robmacl/ilemt_hw/README.md

# ilemt_hw
Hardware design files for ILEMT position tracker. The In-Loop
ElectroMagnetic Tracker (ILEMT) is a project for an open design
electromagnetic tracker. See https://github.com/robmacl/ilemt_hw/wiki
