robmacl/ilemt_hw/docs/Rj45_probe_pinout.xlsx

Sheet: By pin
Pin | 1000BASE-T | ILEMT probe | T568A color | T568B color
1 | DA+ | CFG_GND | white/green stripe | white/orange stripe
2 | DA− | CFG_SIGNAL | green solid | orange solid
3 | DB+ | X- | white/orange stripe | white/green stripe
4 | DC+ | Z+ | blue solid | blue solid
5 | DC− | Z- | white/blue stripe | white/blue stripe
6 | DB− | X+ | orange solid | green solid
7 | DD+ | Y- | white/brown stripe | white/brown stripe
8 | DD− | Y+ | brown solid | brown solid
T568A and T568B define signal pairings for 4 pair twisted pair cable, the RJ45 pinout, and also the wire colors for each signal. T658A and T568B differ in that the orange and green pairs are swapped. So from the view of which RJ45 pins are paired, A and B are identical, and these can be regarded as alternate color mappings.
We use the pairing of an ethernet cable, T468 A or B, but the pair ordering differs from all of T568A, T568B, and 1000BASE-T, which also mutually disagree with each other.
So far as signal signs, 1000BASE-T oddly decided to flip the color signs on pins 4,5 (blue). We consistently go with the convention that solid is +.
 | By pin

Sheet: By ethenet signal
Pin | 1000BASE-T | ILEMT probe | T568A color | T568B color
2 | DA− | CFG_SIGNAL | green solid | orange solid
1 | DA+ | CFG_GND | white/green stripe | white/orange stripe
6 | DB− | X+ | orange solid | green solid
3 | DB+ | X- | white/orange stripe | white/green stripe
5 | DC− | Z- | white/blue stripe | white/blue stripe
4 | DC+ | Z+ | blue solid | blue solid
8 | DD− | Y+ | brown solid | brown solid
7 | DD+ | Y- | white/brown stripe | white/brown stripe
 | By ethernet signal

Sheet: By ILEMT signal
Pin | 1000BASE-T | ILEMT probe | T568A color | T568B color
1 | DA+ | CFG_GND | white/green stripe | white/orange stripe
2 | DA− | CFG_SIGNAL | green solid | orange solid
3 | DB+ | X- | white/orange stripe | white/green stripe
6 | DB− | X+ | orange solid | green solid
7 | DD+ | Y- | white/brown stripe | white/brown stripe
8 | DD− | Y+ | brown solid | brown solid
5 | DC− | Z- | white/blue stripe | white/blue stripe
4 | DC+ | Z+ | blue solid | blue solid
 | By ILEMT signal
