robmacl/ilemt_hw/simetrix/antialias_30khz_bw_response.pdf

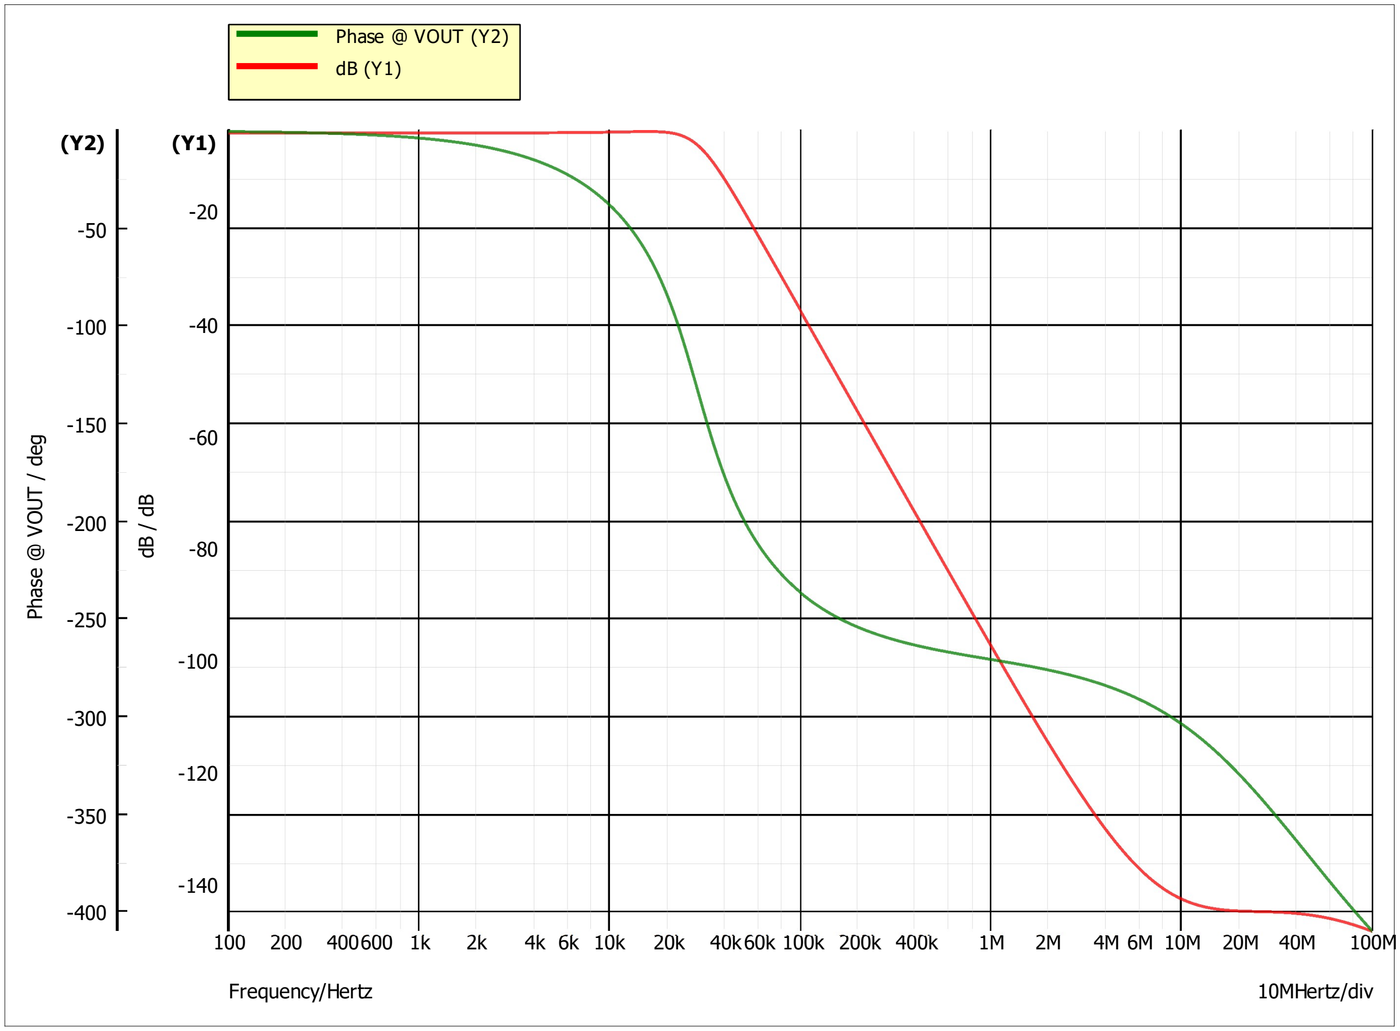
[picture p1: figure]
-20 Phase @ VOUT / deg; Frequency/Hertz; 10MHertz/div; Phase @ VOUT (Y2) dB (Y1)

100 200 400600 1k | 2k | 4k 6k 10k 20k 40k60k 100k 200k 400k | 1M | 2M | 4M 6M 10M 20M 40M | 100M
