robmacl/ilemt_hw/coils/emoto/components/3DV09.pdf

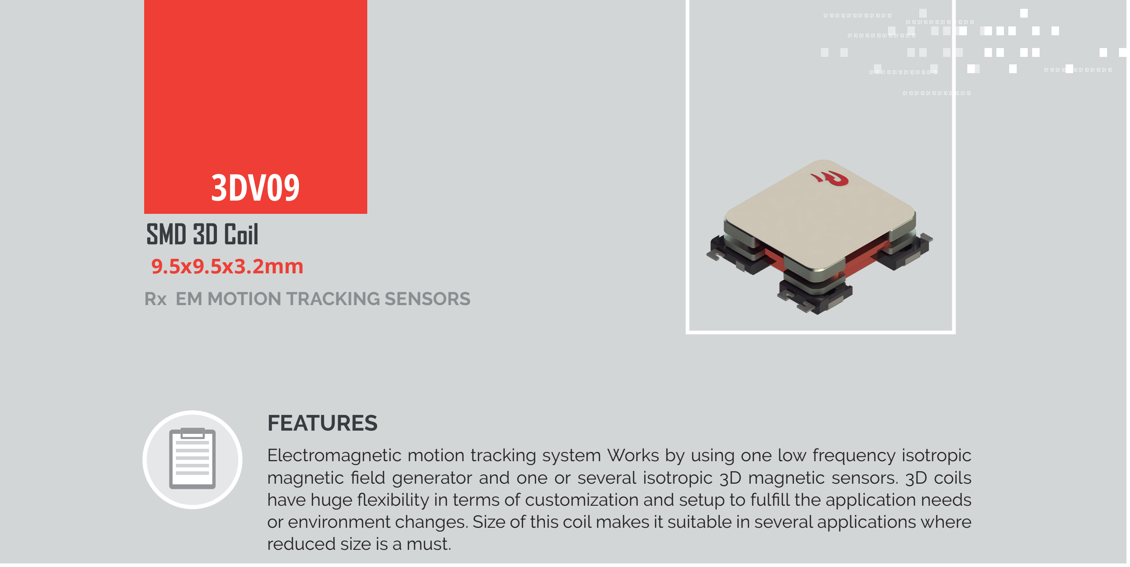
[picture p2: figure]
reduced size is a must.; SMD 3D Coil; FEATURES; Rx EM MOTION TRACKING SENSORS
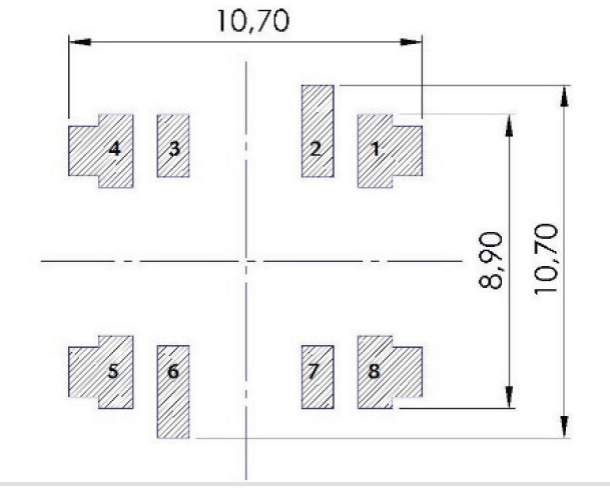
[picture p3: figure]

Electromagnetic motion tracking system Works by using one low frequency isotropic magnetic field generator and one or several isotropic 3D magnetic sensors. 3D coils have huge flexibility in terms of customization and setup to fulfill the application needs or environment changes. Size of this coil makes it suitable in several applications where

> Size 9.5x9.5x3.2 mm
> SMD solution
> Suitable for AOI
> Inductance range: 2-20 mH
> Labelled to allow P&P operations > Sensitivity over 20 mV/A/m.

### 01 CHARACTERISTICS

3DV09

(*) Ask for sensitivity test set up and recommendations

### 02 DIMENSIONS

DIMENSIONS (mm)

ELECTRICAL DIAGRAM

RECOMMENDED PAD-LAYOUT

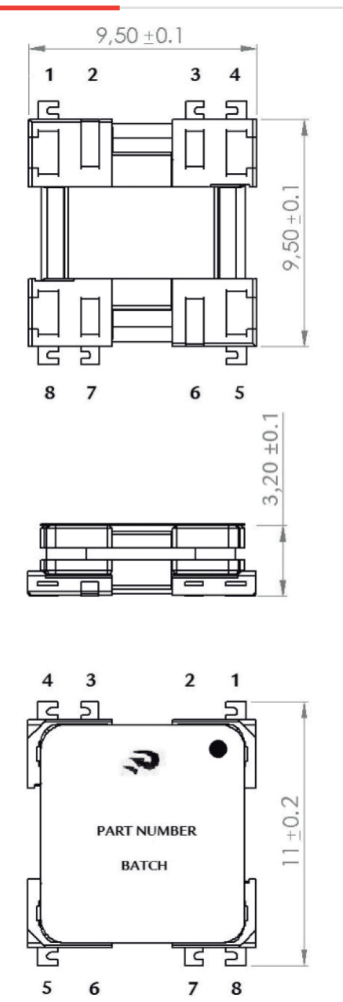
[picture p4: figure]

> Pins coplanarity 0.1 mm

L x,y,z (mH) | 18(xy)/30(z)
Qx,y nom | 4.5(x) /4(y)
4.5(x) /4(y) | 5.5
f(kHz) | 20
SRFx,y (kHz) Min | 150
SRFz (kHz) Min | 450
DCRx (Ohm) Max | 520
DCRy (Ohm) Max | 570
DCRz (Ohm) Max | 715
Sensitivity x,y (mV/A/m) Min (*) | 20
Sensitivity z (mV/A/m) Min (*) | 15
ELECTRICAL SPECIFICATIONS | 3DCV9-A-2000J

Rx EM MOTION TRACKING SENSORS
