robmacl/ilemt_hw/parts/bom_compare.xlsx

Sheet: help
This workbook uses XLOOKUP to reconcile the digikey BOM, Kicad BOM and Digikey cart, comparing quantity in each. On the kicad_bom sheet we also compare the MPN on the Kicad vs. Digikey BOMs. This also detects parts which are in one BOM and not the other. Some quantities for connectors and testpoints are confused because they have different values in the schematic, so are not grouped as a single line. DNP components also create mismatch, since they won't usually be on the Digikey BOM.
Download digikey bom and cart as CSV, open, and copy paste into digikey_bom and cart sheets. Export kicad bom as CSV also, and paste on the kicad_bom sheet. Kicad Tools/Generate bill of materials/bom2grouped_csv. Copy the occupied rectangle from the input CSV, taking care to delete lines if the BOM got shorter.
Since the data is copied in, you are only looking at a particular Kicad project (board) vs. the Digikey info. This is currently for input_board_R1.

Sheet: cart
Index | Quantity | Part Number | Manufacturer Part Number | Description | Customer Reference | Available | Backorder | Unit Price | Extended Price USD | BOM quantity | Cart extra
1 | 4 | HR1645-ND | HR10A-10R-10SB(72) | CONN RCPT FMALE 10POS GOLD SLDR |  | 4 | 0 | 11.62 | 46.48
2 | 4 | HR1634-ND | HR10A-10P-10P(74) | CONN PLUG MALE 10POS SOLDER CUP |  | 4 | 0 | 19.06 | 76.24
3 | 20 | 311-3585-1-ND | CC0805FRNPO0BN102 | CAP CER 1000PF 100V NPO 0805 | I.1 | 20 | 0 | 0.213 | 4.26
4 | 6 | LTC2512CDKD-24#PBF-ND | LTC2512CDKD-24#PBF | IC ADC 24BIT SAR 24DFN | I.3 | 6 | 0 | 21.04 | 126.24
5 | 10 | 240-2396-1-ND | HZ0805C202R-10 | FERRITE BEAD 2 KOHM 0805 1LN | I.5 | 10 | 0 | 0.151 | 1.51
6 | 10 | 311-.068LWCT-ND | RL1206FR-070R068L | RES 0.068 OHM 1% 1/4W 1206 | I.10 | 10 | 0 | 0.361 | 3.61
7 | 10 | 296-8518-1-ND | SN74LVC541ADBR | IC BUF NON-INVERT 3.6V 20SSOP | I.11 | 10 | 0 | 0.477 | 4.77
8 | 10 | AD8599ARZ-ND | AD8599ARZ | IC OPAMP GP 2 CIRCUIT 8SOIC | I.12 | 10 | 0 | 7.84 | 78.40
9 | 10 | CAY16-330J4LFCT-ND | CAY16-330J4LF | RES ARRAY 4 RES 33 OHM 1206 | I.13 | 10 | 0 | 0.065 | 0.65
10 | 10 | 2019-RK73H2BTTD2R74FCT-ND | RK73H2BTTD2R74F | RES 2.74 OHM 1% 1/4W 1206 | I.16 | 10 | 0 | 0.048 | 0.48
11 | 3 | RJHSE5387-ND | RJHSE5387 | CONN MOD JACK 8P8C R/A SHIELDED | I.18 | 3 | 0 | 1.66 | 4.98
12 | 50 | 565-4287-1-ND | APXG160ARA331MHA0G | CAP ALUM POLY 330UF 20% 16V SMD | I.19 | 50 | 0 | 0.7246 | 36.23
13 | 10 | 296-17400-5-ND | OPA830ID | IC OPAMP VFB 1 CIRCUIT 8SOIC | I.20 | 10 | 0 | 2.722 | 27.22
14 | 5 | MF-NSMF050-2CT-ND | MF-NSMF050-2 | PTC RESET FUSE 13.2V 500MA 1206 | I.21 | 5 | 0 | 0.324 | 1.62
15 | 10 | 497-5236-1-ND | 2STD1665T4 | TRANS NPN 65V 6A DPAK | I.22 | 10 | 0 | 0.753 | 7.53
16 | 10 | NSS1C300ET4GOSCT-ND | NSS1C300ET4G | TRANS PNP 100V 3A 3DPAK | I.23 | 10 | 0 | 0.599 | 5.99
17 | 10 | NCP1117STAT3GOSCT-ND | NCP1117STAT3G | IC REG LINEAR POS ADJ 1A SOT223 | I.26 | 10 | 0 | 0.411 | 4.11
18 | 200 | 1276-6471-1-ND | CL21B105KOFNNNG | CAP CER 1UF 16V X7R 0805 | I.27 | 200 | 0 | 0.0243 | 4.86
19 | 10 | 399-5516-1-ND | C1210C476M9RACTU | CAP CER 47UF 6.3V X7R 1210 | I.28 | 10 | 0 | 0.881 | 8.81
20 | 20 | 478-5318-1-ND | 06036D106MAT2A | CAP CER 10UF 6.3V X5R 0603 | I.29 | 20 | 0 | 0.165 | 3.30
21 | 100 | A110514CT-ND | 8-2176091-9 | RES SMD 499 OHM 0.1% 1/4W 0805 | I.30 | 100 | 0 | 0.2568 | 25.68
22 | 3 | 296-46621-1-ND | OPA1679IDR | IC AUDIO 4 CIRCUIT 14SOIC | I.31 | 3 | 0 | 1.23 | 3.69
23 | 10 | S6009-02-ND | NRPN022MAMS-RC | CONN HEADER SMD 4POS 2MM | I.32 | 10 | 0 | 0.392 | 3.92
24 | 4 | 36-1540-2-ND | 1540-2 | TERM TURRET HOLLOW L=6.75MM TIN | I.33 | 4 | 0 | 0.5 | 2.00
25 | 4 | WM5557-ND | 0734151471 | CONN MMCX JACK STR 50 OHM PCB | I.35 | 4 | 0 | 2.53 | 10.12
26 | 15 | 490-6381-1-ND | GRM1885C1H222GA01D | CAP CER 2200PF 50V C0G/NP0 0603 | I.36 | 15 | 0 | 0.133 | 2.00
27 | 10 | FIN1047MTCXFSCT-ND | FIN1047MTCX | IC DRIVER 4/0 16TSSOP | I.38 | 10 | 0 | 1.545 | 15.45
28 | 10 | DS90LV048ATMTC/NOPB-ND | DS90LV048ATMTC/NOPB | IC RECEIVER 0/4 16TSSOP | I.39 | 10 | 0 | 2.904 | 29.04
29 | 20 | 732-9974-1-ND | 824500500 | TVS DIODE 5V 9.2V DO214AC | I.40 | 20 | 0 | 0.252 | 5.04
30 | 10 | P4SMA12A-E3/61GICT-ND | P4SMA12A-E3/61 | TVS DIODE 10.2V 16.7V DO214AC | I.41 | 10 | 0 | 0.274 | 2.74
31 | 10 | 296-46339-1-ND | THS4131CDR | IC OPAMP DIFF 1 CIRCUIT 8SOIC | I.42 | 10 | 0 | 7.343 | 73.43
32 | 100 | BAS21SLT1GOSCT-ND | BAS21SLT1G | DIODE ARRAY GP 250V 225MA SOT23 | I.43 | 81 | 19 | 0.0787 | 7.87
33 | 10 | 311-4211-1-ND | CC0805JKNPO9BN332 | CAP CER 3300PF 50V NPO 0805 | I.45 | 10 | 0 | 0.277 | 2.77
34 | 20 | 445-6945-1-ND | CGA4C2C0G1H682J060AA | CAP CER 6800PF 50V C0G 0805 | I.46 | 20 | 0 | 0.165 | 3.30
35 | 20 | 311-2653-1-ND | RT0603DRE07698RL | RES SMD 698 OHM 0.5% 1/10W 0603 | I.47 | 20 | 0 | 0.092 | 1.84
36 | 10 | RNCP0603FTD392RCT-ND | RNCP0603FTD392R | RES 392 OHM 1% 1/8W 0603 | I.49 | 10 | 0 | 0.058 | 0.58
37 | 20 | RNCP0603FTD301RCT-ND | RNCP0603FTD301R | RES 301 OHM 1% 1/8W 0603 | I.50 | 20 | 0 | 0.058 | 1.16
38 | 20 | P100DBCT-ND | ERA-3AEB101V | RES SMD 100 OHM 0.1% 1/10W 0603 | I.51 | 20 | 0 | 0.26 | 5.20
39 | 100 | RMCF0603FT33R0CT-ND | RMCF0603FT33R0 | RES 33 OHM 1% 1/10W 0603 | I.52 | 100 | 0 | 0.0065 | 0.65
40 | 100 | YAG3354CT-ND | RT0603FRE073K3L | RES SMD 3.3K OHM 1% 1/10W 0603 | I.53 | 100 | 0 | 0.0227 | 2.27
41 | 100 | YAG5945CT-ND | RT0603FRE07200KL | RES SMD 200K OHM 1% 1/10W 0603 | I.54 | 100 | 0 | 0.0227 | 2.27
42 | 100 | RNCP0603FTD200RCT-ND | RNCP0603FTD200R | RES 200 OHM 1% 1/8W 0603 | I.55 | 100 | 0 | 0.0236 | 2.36
43 | 100 | P10KDBCT-ND | ERA-3AEB103V | RES SMD 10K OHM 0.1% 1/10W 0603 | I.56 | 100 | 0 | 0.1015 | 10.15
44 | 10 | P243DBCT-ND | ERA-3AEB2430V | RES SMD 243 OHM 0.1% 1/10W 0603 | I.57 | 10 | 0 | 0.26 | 2.60
45 | 3 | 24LC256T-I/MSCT-ND | 24LC256T-I/MS | IC EEPROM 256KBIT I2C 8MSOP | I.59 | 3 | 0 | 0.84 | 2.52
46 | 3 | 1727-6075-1-ND | 74LVC1G384GV,125 | IC SWITCH SPST 5TSOP | I.60 | 3 | 0 | 0.41 | 1.23
47 | 10 | 399-9672-ND | R60DF4330506AJ | CAP FILM 3.3UF 5% 63VDC RADIAL | M.6 | 10 | 0 | 0.722 | 7.22
48 | 20 | 732-6123-1-ND | 74279220181 | FERRITE BEAD 180 OHM 0805 1LN | M.36 | 20 | 0 | 0.32 | 6.40
49 | 3 | 296-OPA2210IDRCT-ND | OPA2210IDR | IC OPAMP GP 2 CIRCUIT 8SOIC | D.1 | 3 | 0 | 4.57 | 13.71
50 | 50 | 311-1341-1-ND | CC0603KRX7R8BB104 | CAP CER 0.1UF 25V X7R 0603 | I.2 | 50 | 0 | 0.0248 | 1.24
51 | 100 | 541-10TACT-ND | CRCW080510R0JNEAHP | RES SMD 10 OHM 5% 1/2W 0805 | I.9 | 100 | 0 | 0.0757 | 7.57
52 | 25 | 587-1765-1-ND | FBMJ2125HM210NT | FERRITE BEAD 21 OHM 0805 1LN | I.24 | 25 | 0 | 0.07 | 1.75
53 | 10 | 311-1065-1-ND | CC0603JRNPO9BN470 | CAP CER 47PF 50V C0G/NPO 0603 | I.44 | 10 | 0 | 0.038 | 0.38
54 | 100 | YAG1237CT-ND | RT0603BRD071KL | RES SMD 1K OHM 0.1% 1/10W 0603 | I.48 | 100 | 0 | 0.1073 | 10.73
55 | 10 | 311-0.0GRCT-ND | RC0603JR-070RL | RES SMD 0 OHM JUMPER 1/10W 0603 | M.12 | 10 | 0 | 0.017 | 0.17
56 | 100 | WM1138CT-ND | 0039000059 | CONN SOCKET 18-24AWG CRIMP TIN |  | 100 | 0 | 0.061 | 6.10
57 | 20 | WM3700-ND | 0039012020 | CONN RECEPT 2POS DUAL |  | 20 | 0 | 0.194 | 3.88
58 | 10 | WM3701-ND | 0039012040 | CONN RECEPT 4POS DUAL | P.8.1 | 10 | 0 | 0.221 | 2.21
59 | 1 | 2260-SSNC-T5-15G-ND | SSNC-T5-15G | 63/37 SOLDER PASTE T5 - 15 GRAMS |  | 1 | 0 | 16.99 | 16.99
60 | 1 | 2328-18UL1007STRWHI-ND | 18UL1007STRWHI | HOOK-UP STRND 18AWG 300V WHITE |  | 1 | 0 | 20.57 | 20.57
61 | 1 | 2328-18UL1007STRRED-ND | 18UL1007STRRED | HOOK-UP STRND 18AWG 300V RED |  | 1 | 0 | 20.57 | 20.57
62 | 50 | 490-GCM2195C1K103FA16DCT-ND | GCM2195C1K103FA16D | CERAMIC CAP AEC-Q200 | I.14 | 50 | 0 | 0.321 | 16.05
63 | 20 | YAG1859CT-ND | RT0805BRD072KL | RES SMD 2K OHM 0.1% 1/8W 0805 | I.17 | 20 | 0 | 0.259 | 5.18

Sheet: digikey_bom
Manufacturer Part Number | Manufacturer | Digi-Key Part Number | Customer Reference | Reference Designator | Packaging | Quantity | Unit Price | Extended Price | Quantity Available | Description | Cart | Cart extra | Kicad | Kicad diff
OPA2210IDR | Texas Instruments | 296-OPA2210IDRCT-ND | D.1 | U3 | Cut Tape (CT) | 1 | 4.57 | $4.57 | 1201 | IC OPAMP GP 2 CIRCUIT 8SOIC | 3 | 1 | 1 | 0 | Num assemblies:
CC0805FRNPO0BN102 | Yageo | 311-3585-1-ND | I.1 | C31 | Cut Tape (CT) | 6 | 0.31 | $1.86 | 255 | CAP CER 1000PF 100V NPO 0805 | 20 | 8 | 6 | 0 | 2
RL1206FR-070R068L | Yageo | 311-.068LWCT-ND | I.10 | R7 | Cut Tape (CT) | 1 | 0.5 | $0.50 | 30227 | RES 0.068 OHM 1% 1/4W 1206 | 10 | 8 | 1 | 0
SN74LVC541ADBR | Texas Instruments | 296-8518-1-ND | I.11 | U5 | Cut Tape (CT) | 1 | 0.56 | $0.56 | 1491 | IC BUF NON-INVERT 3.6V 20SSOP | 10 | 8 | 1 | 0
AD8599ARZ | Analog Devices Inc. | AD8599ARZ-ND | I.12 | U101 | Tube | 3 | 8.68 | $26.04 | 313 | IC OPAMP GP 2 CIRCUIT 8SOIC | 10 | 4 | 3 | 0
CAY16-330J4LF | Bourns Inc. | CAY16-330J4LFCT-ND | I.13 | RN1 | Cut Tape (CT) | 2 | 0.1 | $0.20 | 215903 | RES ARRAY 4 RES 33 OHM 1206 | 10 | 6 | 2 | 0
GRM2195C1H103GA01D | Murata Electronics | 490-8296-1-ND | I.14 | C1, C2, C32 | Cut Tape (CT) | 16 | 0 | $0.00 | 24000 | CAP CER 10000PF 50V C0G/NP0 0805 | 50 | 18 | 16 | 0
RK73H2BTTD2R74F | KOA Speer Electronics, Inc. | 2019-RK73H2BTTD2R74FCT-ND | I.16 | R6 | Cut Tape (CT) | 1 | 0.1 | $0.10 | 1879 | RES 2.74 OHM 1% 1/4W 1206 | 10 | 8 | 1 | 0
ERA-6AEB202V | Panasonic Electronic Components | P2.0KDACT-ND | I.17 | R1 | Cut Tape (CT) | 5 | 0.31 | $1.55 | 3418 | RES 2K OHM 0.1% 1/8W 0805 | 20 | 10 | 5 | 0
RJHSE5387 | Amphenol ICC (Commercial Products) | RJHSE5387-ND | I.18 | J1 | Tray | 1 | 1.66 | $1.66 | 1520 | CONN MOD JACK 8P8C R/A SHIELDED | 3 | 1 | 1 | 0
APXG160ARA331MHA0G | United Chemi-Con | 565-4287-1-ND | I.19 | C7 | Cut Tape (CT) | 18 | 0.872 | $15.69 | 1024 | CAP ALUM POLY 330UF 20% 16V SMD | 50 | 14 | 18 | 0
CC0603KRX7R8BB104 | Yageo | 311-1341-1-ND | I.2 | C18 | Cut Tape (CT) | 17 | 0.045 | $0.76 | 9242198 | CAP CER 0.1UF 25V X7R 0603 | 50 | 16 | 17 | 0
OPA830ID | Texas Instruments | 296-17400-5-ND | I.20 | U4, U6 | Tube | 2 | 3.03 | $6.06 | 184 | IC OPAMP VFB 1 CIRCUIT 8SOIC | 10 | 6 | 2 | 0
MF-NSMF050-2 | Bourns Inc. | MF-NSMF050-2CT-ND | I.21 | F1, F2 | Cut Tape (CT) | 2 | 0.33 | $0.66 | 5878 | PTC RESET FUSE 13.2V 500MA 1206 | 5 | 1 | 2 | 0
2STD1665T4 | STMicroelectronics | 497-5236-1-ND | I.22 | Q2 | Cut Tape (CT) | 1 | 0.92 | $0.92 | 8311 | TRANS NPN 65V 6A DPAK | 10 | 8 | 1 | 0
NSS1C300ET4G | ON Semiconductor | NSS1C300ET4GOSCT-ND | I.23 | Q1 | Cut Tape (CT) | 2 | 0.69 | $1.38 | 1910 | TRANS PNP 100V 3A 3DPAK | 10 | 6 | 2 | 0
FBMJ2125HM210NT | Taiyo Yuden | 587-1765-1-ND | I.24 | FB1 | Cut Tape (CT) | 9 | 0.11 | $0.99 | 26842 | FERRITE BEAD 21 OHM 0805 1LN | 25 | 7 | 9 | 0
NCP1117STAT3G | ON Semiconductor | NCP1117STAT3GOSCT-ND | I.26 | U8 | Cut Tape (CT) | 2 | 0.48 | $0.96 | 30695 | IC REG LINEAR POS ADJ 1A SOT223 | 10 | 6 | 2 | 0
CL21B105KOFNNNG | Samsung Electro-Mechanics | 1276-6471-1-ND | I.27 | C3 | Cut Tape (CT) | 52 | 0.0298 | $1.54 | 546379 | CAP CER 1UF 16V X7R 0805 | 200 | 96 | 52 | 0
C1210C476M9RACTU | KEMET | 399-5516-1-ND | I.28 | C5, C6, C109 | Cut Tape (CT) | 3 | 1.16 | $3.48 | 256 | CAP CER 47UF 6.3V X7R 1210 | 10 | 4 | 3 | 0
06036D106MAT2A | AVX Corporation | 478-5318-1-ND | I.29 | C24, C104, C105 | Cut Tape (CT) | 8 | 0.24 | $1.92 | 1787235 | CAP CER 10UF 6.3V X5R 0603 | 20 | 4 | 8 | 0
LTC2512CDKD-24#PBF | Analog Devices Inc. | LTC2512CDKD-24#PBF-ND | I.3 | U102 | Tube | 3 | 21.04 | $63.12 | 95 | IC ADC 24BIT SAR 24DFN | 6 | 0 | 3 | 0
8-2176091-9 | TE Connectivity Passive Product | A110514CT-ND | I.30 | R5 | Cut Tape (CT) | 10 | 0.494 | $4.94 | 5780 | RES SMD 499 OHM 0.1% 1/4W 0805 | 100 | 80 | 10 | 0
OPA1679IDR | Texas Instruments | 296-46621-1-ND | I.31 | U9 | Cut Tape (CT) | 1 | 1.23 | $1.23 | 14643 | IC AUDIO 4 CIRCUIT 14SOIC | 3 | 1 | 1 | 0
NRPN022MAMS-RC | Sullins Connector Solutions | S6009-02-ND | I.32 | J3 | Tube | 4 | 0.42 | $1.68 | 3935 | CONN HEADER SMD 4POS 2MM | 10 | 2 | 3 | -1
1540-2 | Keystone Electronics | 36-1540-2-ND | I.33 |  | Bulk | 2 | 0.5 | $1.00 | 5738 | TERM TURRET HOLLOW L=6.75MM TIN | 4 | 0 | 2 | 0
734151471 | Molex | WM5557-ND | I.35 | J2 | Bulk | 2 | 2.53 | $5.06 | 8854 | CONN MMCX JACK STR 50 OHM PCB | 4 | 0 | 3 | 1
GRM1885C1H222GA01D | Murata Electronics | 490-6381-1-ND | I.36 | C112 | Cut Tape (CT) | 6 | 0.19 | $1.14 | 32000 | CAP CER 2200PF 50V C0G/NP0 0603 | 15 | 3 | 6 | 0
FIN1047MTCX | ON Semiconductor | FIN1047MTCXFSCT-ND | I.38 | U2 | Cut Tape (CT) | 1 | 1.72 | $1.72 | 6838 | IC DRIVER 4/0 16TSSOP | 10 | 8 | 1 | 0
DS90LV048ATMTC/NOPB | Texas Instruments | DS90LV048ATMTC/NOPB-ND | I.39 | U1 | Tube | 1 | 3.23 | $3.23 | 2462 | IC RECEIVER 0/4 16TSSOP | 10 | 8 | 1 | 0
824500500 | Würth Elektronik | 732-9974-1-ND | I.40 | D9 | Cut Tape (CT) | 6 | 0.27 | $1.62 | 845 | TVS DIODE 5V 9.2V DO214AC | 20 | 8 | 6 | 0
P4SMA12A-E3/61 | Vishay General Semiconductor - Diodes Division | P4SMA12A-E3/61GICT-ND | I.41 | D4 | Cut Tape (CT) | 3 | 0.39 | $1.17 | 472 | TVS DIODE 10.2V 16.7V DO214AC | 10 | 4 | 3 | 0
THS4131CDR | Texas Instruments | 296-46339-1-ND | I.42 | U104 | Cut Tape (CT) | 3 | 8.13 | $24.39 | 1072 | IC OPAMP DIFF 1 CIRCUIT 8SOIC | 10 | 4 | 3 | 0
BAS21SLT1G | ON Semiconductor | BAS21SLT1GOSCT-ND | I.43 | D1 | Cut Tape (CT) | 26 | 0.146 | $3.79 | 3081 | DIODE ARRAY GP 250V 225MA SOT23 | 100 | 48 | 26 | 0
CC0603JRNPO9BN470 | Yageo | 311-1065-1-ND | I.44 | C12 | Cut Tape (CT) | 2 | 0.1 | $0.20 | 206557 | CAP CER 47PF 50V C0G/NPO 0603 | 10 | 6 | 2 | 0
CC0805JKNPO9BN332 | Yageo | 311-4211-1-ND | I.45 | C122 | Cut Tape (CT) | 3 | 0.4 | $1.20 | 16461 | CAP CER 3300PF 50V NPO 0805 | 10 | 4 | 3 | 0
CGA4C2C0G1H682J060AA | TDK Corporation | 445-6945-1-ND | I.46 | C102 | Cut Tape (CT) | 6 | 0.24 | $1.44 | 4813 | CAP CER 6800PF 50V C0G 0805 | 20 | 8 | 6 | 0
RT0603DRE07698RL | Yageo | 311-2653-1-ND | I.47 | R107 | Cut Tape (CT) | 6 | 0.1 | $0.60 | 19890 | RES SMD 698 OHM 0.5% 1/10W 0603 | 20 | 8 | 6 | 0
RT0603BRD071KL | Yageo | YAG1237CT-ND | I.48 | R14 | Cut Tape (CT) | 19 | 0.274 | $5.20 | 218515 | RES SMD 1K OHM 0.1% 1/10W 0603 | 100 | 62 | 19 | 0
RNCP0603FTD392R | Stackpole Electronics Inc | RNCP0603FTD392RCT-ND | I.49 | R12 | Cut Tape (CT) | 2 | 0.1 | $0.20 | 4000 | RES 392 OHM 1% 1/8W 0603 | 10 | 6 | 2 | 0
HZ0805C202R-10 | Laird-Signal Integrity Products | 240-2396-1-ND | I.5 | FB5 | Cut Tape (CT) | 1 | 0.18 | $0.18 | 137193 | FERRITE BEAD 2 KOHM 0805 1LN | 10 | 8 | 1 | 0
RNCP0603FTD301R | Stackpole Electronics Inc | RNCP0603FTD301RCT-ND | I.50 | R9 | Cut Tape (CT) | 5 | 0.1 | $0.50 | 6294 | RES 301 OHM 1% 1/8W 0603 | 20 | 10 | 5 | 0
ERA-3AEB101V | Panasonic Electronic Components | P100DBCT-ND | I.51 | R126 | Cut Tape (CT) | 6 | 0.31 | $1.86 | 12368 | RES SMD 100 OHM 0.1% 1/10W 0603 | 20 | 8 | 6 | 0
RMCF0603FT33R0 | Stackpole Electronics Inc | RMCF0603FT33R0CT-ND | I.52 | R17 | Cut Tape (CT) | 9 | 0.1 | $0.90 | 380426 | RES 33 OHM 1% 1/10W 0603 | 100 | 82 | 9 | 0
RT0603FRE073K3L | Yageo | YAG3354CT-ND | I.53 | R23 | Cut Tape (CT) | 11 | 0.056 | $0.61 | 88389 | RES SMD 3.3K OHM 1% 1/10W 0603 | 100 | 78 | 11 | 0
RT0603FRE07200KL | Yageo | YAG5945CT-ND | I.54 | R113 | Cut Tape (CT) | 13 | 0.056 | $0.72 | 2540 | RES SMD 200K OHM 1% 1/10W 0603 | 100 | 74 | 13 | 0
RNCP0603FTD200R | Stackpole Electronics Inc | RNCP0603FTD200RCT-ND | I.55 | R21 | Cut Tape (CT) | 10 | 0.058 | $0.58 | 34202 | RES 200 OHM 1% 1/8W 0603 | 100 | 80 | 10 | 0
ERA-3AEB103V | Panasonic Electronic Components | P10KDBCT-ND | I.56 | R120 | Cut Tape (CT) | 12 | 0.26 | $3.12 | 307399 | RES SMD 10K OHM 0.1% 1/10W 0603 | 100 | 76 | 12 | 0
ERA-3AEB2430V | Panasonic Electronic Components | P243DBCT-ND | I.57 | R127 | Cut Tape (CT) | 3 | 0.31 | $0.93 | 8025 | RES SMD 243 OHM 0.1% 1/10W 0603 | 10 | 4 | 3 | 0
24LC256T-I/MS | Microchip Technology | 24LC256T-I/MSCT-ND | I.59 | U10 | Cut Tape (CT) | 1 | 0.84 | $0.84 | 1285 | IC EEPROM 256KBIT I2C 8MSOP | 3 | 1 | 1 | 0
74LVC1G384GV,125 | Nexperia USA Inc. | 1727-6075-1-ND | I.60 | U11 | Cut Tape (CT) | 1 | 0.41 | $0.41 | 22140 | IC SWITCH SPST 5TSOP | 3 | 1 | 1 | 0
CRCW080510R0JNEAHP | Vishay Dale | 541-10TACT-ND | I.9 | R15 | Cut Tape (CT) | 26 | 0.194 | $5.04 | 231 | RES SMD 10 OHM 5% 1/2W 0805 | 100 | 48 | 26 | 0
RC0603JR-070RL | Yageo | 311-0.0GRCT-ND | M.12 |  | Cut Tape (CT) | 1 | 0.1 | $0.10 | R38 | RES SMD 0 OHM JUMPER 1/10W 0603 | 10 | 8 | 1 | 0
74279220181 | Würth Elektronik | 732-6123-1-ND | M.36 |  | Cut Tape (CT) | 4 | 0.32 | $1.28 | FB1 | FERRITE BEAD 180 OHM 0805 1LN | 20 | 12 | 4 | 0
R60DF4330506AJ | KEMET | 399-9672-ND | M.6 |  | Bulk | 1 | 0.91 | $0.91 | C42 | CAP FILM 3.3UF 5% 63VDC RADIAL | 10 | 8 | 1 | 0

Sheet: kicad_bom
Reference | Quantity | Value | DK line | Description | Digikey | MPN | Manufacturer | DK quan | DK diff | DK MPN | MPN match | DK descr | descr match
U3 | 1 | OPA2210 | D.1 | IC OPAMP 2 CIRCUIT | 296-OPA2210IDRCT-ND | OPA2210IDR | Texas Instruments | 1 | 0 | OPA2210IDR | TRUE | IC OPAMP GP 2 CIRCUIT 8SOIC | FALSE
C127 C128 C219 C220 C319 C320 | 6 | 1nF | I.1 | CAP CER 1000PF 100V NPO 0805 | 311-3585-1-ND | CC0805FRNPO0BN102 | Yageo | 6 | 0 | CC0805FRNPO0BN102 | TRUE | CAP CER 1000PF 100V NPO 0805 | TRUE
R7 | 1 | 68m | I.10 | RES 0.068 OHM 1% 1/4W 1206 | 311-.068LWCT-ND | RL1206FR-070R068L | Yageo | 1 | 0 | RL1206FR-070R068L | TRUE | RES 0.068 OHM 1% 1/4W 1206 | TRUE
U5 | 1 | 74LVC541A | I.11 | IC BUF NON-INVERT 3.6V 20SSOP | 296-8518-1-ND | SN74LVC541ADBR | Texas Instruments | 1 | 0 | SN74LVC541ADBR | TRUE | IC BUF NON-INVERT 3.6V 20SSOP | TRUE
U101 U202 U302 | 3 | AD8599 | I.12 | IC OPAMP GP 2 CIRCUIT 8SOIC | AD8599ARZ-ND | AD8599ARZ | Analog Devices Inc. | 3 | 0 | AD8599ARZ | TRUE | IC OPAMP GP 2 CIRCUIT 8SOIC | TRUE
RN1 RN2 | 2 | 33 | I.13 | RES ARRAY 4 RES 33 OHM 1206 | CAY16-330J4LFCT-ND | CAY16-330J4LF | Bourns Inc. | 2 | 0 | CAY16-330J4LF | TRUE | RES ARRAY 4 RES 33 OHM 1206 | TRUE
C1 C2 C35 C36 C37 C38 C41 C111 C129 C130 C203 C221 C222 C303 C321 C322 | 16 | 10nF | I.14 | CAP CER 10000PF 50V C0G/NP0 0805 | 490-8296-1-ND | GRM2195C1H103GA01D | Murata Electronics | 16 | 0 | GRM2195C1H103GA01D | TRUE | CAP CER 10000PF 50V C0G/NP0 0805 | TRUE
R6 | 1 | 2.74 | I.16 | 2.74 Ohms Â±1% 0.25W, 1/4W Chip Resistor 1206 (3216 Metric) Automotive AEC-Q200, Moisture Resistant Thick Film | 2019-RK73H2BTTD2R74FCT-ND | RK73H2BTTD2R74F | KOA Speer Electronics, Inc. | 1 | 0 | RK73H2BTTD2R74F | TRUE | RES 2.74 OHM 1% 1/4W 1206 | FALSE
R1 R2 R3 R4 R36 | 5 | 2K | I.17 | RES 2K OHM 0.1% 1/8W 0805 | P2.0KDACT-ND | ERA-6AEB202V | Panasonic Electronic Components | 5 | 0 | ERA-6AEB202V | TRUE | RES 2K OHM 0.1% 1/8W 0805 | TRUE
J1 | 1 | Sensor | I.18 | CONN MOD JACK 8P8C R/A SHIELDED | RJHSE5387-ND | RJHSE5387 | Amphenol ICC (Commercial Products) | 1 | 0 | RJHSE5387 | TRUE | CONN MOD JACK 8P8C R/A SHIELDED | TRUE
C5 C7 C11 C14 C15 C20 C21 C25 C26 C110 C119 C133 C201 C202 C235 C301 C302 C335 | 18 | 330uF | I.19 | 16V aluminum solid polymer, ESR 22 mOhm | 565-4285-1-ND | APXG160ARA331MH70G | United Chemi-Con | 18 | 0 | APXG160ARA331MHA0G | FALSE | CAP ALUM POLY 330UF 20% 16V SMD | FALSE
C18 C19 C29 C30 C33 C34 C43 C44 C106 C107 C108 C231 C232 C233 C331 C332 C333 | 17 | 100nF | I.2 | CAP CER 0.1UF 25V X7R 0603 | 311-1341-1-ND | CC0603KRX7R8BB104 | Yageo | 17 | 0 | CC0603KRX7R8BB104 | TRUE | CAP CER 0.1UF 25V X7R 0603 | TRUE
U4 U6 | 2 | OPA830 | I.20 | IC OPAMP VFB 1 CIRCUIT 8SOIC | 296-17400-5-ND | OPA830ID | Texas Instruments | 2 | 0 | OPA830ID | TRUE | IC OPAMP VFB 1 CIRCUIT 8SOIC | TRUE
F1 F2 | 2 | 750 mA 90 mOhm | I.21 | PTC RESET FUSE 16V 750MA 1206 | 507-1805-1-ND | 0ZCJ0075AF2E | Bel Fuse Inc. | 2 | 0 | MF-NSMF050-2 | FALSE | PTC RESET FUSE 13.2V 500MA 1206 | FALSE
Q2 | 1 | 2STD1665T4 | I.22 | TRANS NPN 65V 6A DPAK | 497-5236-1-ND | 2STD1665T4 | STMicroelectronics | 1 | 0 | 2STD1665T4 | TRUE | TRANS NPN 65V 6A DPAK | TRUE
Q1 Q3 | 2 | NSS1C300ET4G | I.23 | TRANS PNP 100V 3A 3DPAK | NSS1C300ET4GOSCT-ND | NSS1C300ET4G | ON Semiconductor | 2 | 0 | NSS1C300ET4G | TRUE | TRANS PNP 100V 3A 3DPAK | TRUE
FB103 FB104 FB105 FB201 FB202 FB205 FB301 FB302 FB305 | 9 | 21 Ohm | I.24 | FERRITE BEAD 21 OHM 0805, 100 nH, 5 mOhm | 587-1765-1-ND | FBMJ2125HM210NT | Taiyo Yuden | 9 | 0 | FBMJ2125HM210NT | TRUE | FERRITE BEAD 21 OHM 0805 1LN | FALSE
U7 U8 | 2 | NCP1117STAT3G | I.26 | IC REG LINEAR POS ADJ 1A SOT223 | NCP1117STAT3GOSCT-ND | NCP1117STAT3G | ON Semiconductor | 2 | 0 | NCP1117STAT3G | TRUE | IC REG LINEAR POS ADJ 1A SOT223 | TRUE
C3 C4 C8 C9 C10 C16 C17 C22 C23 C27 C28 C39 C40 C113 C115 C116 C117 C118 C123 C124 C125 C126 C131 C132 C134 C135 C204 C207 C208 C209 C210 C211 C215 C216 C217 C218 C223 C224 C225 C304 C307 C308 C309 C310 C311 C315 C316 C317 C318 C323 C324 C325 | 52 | 1uF | I.27 | CAP CER 1UF 16V X7R 0805 | 1276-6471-1-ND | CL21B105KOFNNNG | Samsung Electro-Mechanics | 52 | 0 | CL21B105KOFNNNG | TRUE | CAP CER 1UF 16V X7R 0805 | FALSE
C109 C234 C334 | 3 | 47uF | I.28 | CAP CER 47UF 6.3V X7R 1210 | 399-5516-1-ND | C1210C476M9RACTU | KEMET | 3 | 0 | C1210C476M9RACTU | TRUE | CAP CER 47UF 6.3V X7R 1210 | TRUE
C6 C24 C104 C105 C229 C230 C329 C330 | 8 | 10uF | I.29 | CAP CER 10UF 6.3V X5R 0603 | 478-5318-1-ND | 06036D106MAT2A | AVX Corporation | 8 | 0 | 06036D106MAT2A | TRUE | CAP CER 10UF 6.3V X5R 0603 | TRUE
U102 U203 U303 | 3 | LTC2512-24 | I.3 | IC ADC 24BIT SAR 24DFN | LTC2512CDKD-24#PBF-ND | LTC2512CDKD-24#PBF | Linear Technology/Analog Devices | 3 | 0 | LTC2512CDKD-24#PBF | TRUE | IC ADC 24BIT SAR 24DFN | TRUE
R8 R10 R11 R13 R129 R130 R227 R228 R327 R328 | 10 | 499 | I.30 | RES SMD 499 OHM 0.1% 1/4W 0805 | A110514CT-ND | 8-2176091-9 | TE Connectivity Passive Product | 10 | 0 | 8-2176091-9 | TRUE | RES SMD 499 OHM 0.1% 1/4W 0805 | TRUE
U9 | 1 | OPA1679 | I.31 | IC AUDIO 4 CIRCUIT 14SOIC | 296-46621-1-ND | OPA1679IDR | Texas Instruments | 1 | 0 | OPA1679IDR | TRUE | IC AUDIO 4 CIRCUIT 14SOIC | TRUE
J101 J201 J301 | 3 | Gain | I.32 | CONN HEADER SMD 4POS 2MM | S6009-02-ND | NRPN022MAMS-RC | Sullins Connector Solutions | 4 | 1 | NRPN022MAMS-RC | TRUE | CONN HEADER SMD 4POS 2MM | TRUE
J3 | 1 | Decimate | I.32 | CONN HEADER SMD 4POS 2MM | S6009-02-ND | NRPN022MAMS-RC | Sullins Connector Solutions | 4 | 3 | NRPN022MAMS-RC | TRUE | CONN HEADER SMD 4POS 2MM | TRUE
TP4 TP10 | 2 | GND | I.33 | TERM TURRET HOLLOW L=6.75MM TIN | 36-1540-2-ND | 1540-2 | Keystone Electronics | 2 | 0 | 1540-2 | TRUE | TERM TURRET HOLLOW L=6.75MM TIN | TRUE
J102 J202 J302 | 3 | #NAME? | I.35 | Do Not Populate |  | DNP |  | 2 | -1 | 734151471 | FALSE | CONN MMCX JACK STR 50 OHM PCB | FALSE
J103 J203 J303 | 3 | #NAME? | I.35 | Do Not Populate |  | DNP |  | 2 | -1 | 734151471 | FALSE | CONN MMCX JACK STR 50 OHM PCB | FALSE
J2 | 1 | SCKB | I.35 | Do Not Populate |  | DNP |  | 2 | 1 | 734151471 | FALSE | CONN MMCX JACK STR 50 OHM PCB | FALSE
J4 | 1 | SCKA | I.35 | Do Not Populate |  | DNP |  | 2 | 1 | 734151471 | FALSE | CONN MMCX JACK STR 50 OHM PCB | FALSE
J5 | 1 | MCLK | I.35 | Do Not Populate |  | DNP |  | 2 | 1 | 734151471 | FALSE | CONN MMCX JACK STR 50 OHM PCB | FALSE
J6 | 1 | SDOB1 | I.35 | Do Not Populate |  | DNP |  | 2 | 1 | 734151471 | FALSE | CONN MMCX JACK STR 50 OHM PCB | FALSE
C112 C114 C205 C206 C305 C306 | 6 | 2.2nF | I.36 | 2200pF Â±2% 50V Ceramic Capacitor C0G, NP0 0603 (1608 Metric) | 490-6381-1-ND | GRM1885C1H222GA01D | Murata Electronics | 6 | 0 | GRM1885C1H222GA01D | TRUE | CAP CER 2200PF 50V C0G/NP0 0603 | FALSE
U2 | 1 | FIN1047 | I.38 | IC DRIVER 4/0 16TSSOP | FIN1047MTCXFSCT-ND | FIN1047MTCX | ON Semiconductor | 1 | 0 | FIN1047MTCX | TRUE | IC DRIVER 4/0 16TSSOP | TRUE
U1 | 1 | DS90LV048 | I.39 | 0/4 Receiver LVDS 16-TSSOP | DS90LV048ATMTC/NOPB-ND | DS90LV048ATMTC/NOPB | Texas Instruments | 1 | 0 | DS90LV048ATMTC/NOPB | TRUE | IC RECEIVER 0/4 16TSSOP | FALSE
D10 D11 D16 D111 D202 D303 | 6 | 5V (standoff) | I.40 | TVS DIODE 5V 9.2V DO214AC | 732-9974-1-ND | 824500500 | WÃ¼rth Elektronik | 6 | 0 | 824500500 | TRUE | TVS DIODE 5V 9.2V DO214AC | TRUE
D4 D8 D15 | 3 | 10V (standoff) | I.41 | TVS DIODE 10V 17V DO214AC | P4SMA12A-E3/61GICT-ND | P4SMA12A-E3/61 | Vishay General Semiconductor - Diodes Division | 3 | 0 | P4SMA12A-E3/61 | TRUE | TVS DIODE 10.2V 16.7V DO214AC | FALSE
U104 U201 U301 | 3 | THS4131 | I.42 | IC OPAMP DIFF 1 CIRCUIT 8SOIC | 296-46339-1-ND | THS4131CDR | Texas Instruments | 3 | 0 | THS4131CDR | TRUE | IC OPAMP DIFF 1 CIRCUIT 8SOIC | TRUE
D1 D2 D103 D104 D105 D106 D107 D108 D109 D110 D201 D205 D206 D207 D208 D209 D210 D211 D301 D302 D306 D307 D308 D309 D310 D311 | 26 | BAS21S | I.43 | DIODE ARRAY GP 250V 225MA SOT23 | BAS21SLT1GOSCT-ND | BAS21SLT1G | ON Semiconductor | 26 | 0 | BAS21SLT1G | TRUE | DIODE ARRAY GP 250V 225MA SOT23 | TRUE
C12 C13 | 2 | 47pF | I.44 | 47pF Â±5% 50V Ceramic Capacitor C0G, NP0 0603 (1608 Metric) | 311-1065-1-ND | CC0603JRNPO9BN470 | Yageo | 2 | 0 | CC0603JRNPO9BN470 | TRUE | CAP CER 47PF 50V C0G/NPO 0603 | FALSE
C122 C214 C314 | 3 | 3.3nF | I.45 | 3300pF Â±5% 50V Ceramic Capacitor C0G, NP0 0805 (2012 Metric) | 311-4211-1-ND | CC0805JKNPO9BN332 | Yageo | 3 | 0 | CC0805JKNPO9BN332 | TRUE | CAP CER 3300PF 50V NPO 0805 | FALSE
C102 C103 C227 C228 C327 C328 | 6 | 6.8nF | I.46 | 6800pF Â±5% 50V Ceramic Capacitor C0G, NP0 0805 (2012 Metric) | 445-7515-1-ND | C2012C0G1H682J060AA | TDK Corporation | 6 | 0 | CGA4C2C0G1H682J060AA | FALSE | CAP CER 6800PF 50V C0G 0805 | FALSE
R107 R109 R203 R204 R303 R304 | 6 | 698 | I.47 | 698 Ohms Â±0.5% 0.1W, 1/10W Chip Resistor 0603 (1608 Metric) Thin Film | 311-2653-1-ND | RT0603DRE07698RL | Yageo | 6 | 0 | RT0603DRE07698RL | TRUE | RES SMD 698 OHM 0.5% 1/10W 0603 | FALSE
R32 R33 R34 R35 R105 R106 R108 R110 R128 R201 R202 R207 R208 R226 R301 R302 R307 R308 R326 | 19 | 1K | I.48 | RES SMD 1K OHM 0.1% 1/10W 0603 | P1.0KDBCT-ND | ERA-3AEB102V | Panasonic Electronic Components | 19 | 0 | RT0603BRD071KL | FALSE | RES SMD 1K OHM 0.1% 1/10W 0603 | TRUE
R12 R20 | 2 | 392 | I.49 | 392 Ohms Â±1% 0.125W, 1/8W Chip Resistor 0603 (1608 Metric) Anti-Sulfur, Moisture Resistant Thin Film | RNCP0603FTD392RCT-ND | RNCP0603FTD392R | Stackpole Electronics Inc | 2 | 0 | RNCP0603FTD392R | TRUE | RES 392 OHM 1% 1/8W 0603 | FALSE
FB7 | 1 | 2K Ohm | I.5 | FERRITE BEAD 2 KOHM 0805 1LN | 240-2396-1-ND | HZ0805C202R-10 | Laird-Signal Integrity Products | 1 | 0 | HZ0805C202R-10 | TRUE | FERRITE BEAD 2 KOHM 0805 1LN | TRUE
R5 R9 R14 R19 R41 | 5 | 301 | I.50 | 301 Ohms Â±1% 0.125W, 1/8W Chip Resistor 0603 (1608 Metric) Anti-Sulfur, Moisture Resistant Thin Film | RNCP0603FTD301RCT-ND | RNCP0603FTD301R | Stackpole Electronics Inc | 5 | 0 | RNCP0603FTD301R | TRUE | RES 301 OHM 1% 1/8W 0603 | FALSE
R29 R30 R31 R126 R224 R324 | 6 | 100 | I.51 | 100 Ohms Â±0.1% 0.1W, 1/10W Chip Resistor 0603 (1608 Metric) Automotive AEC-Q200 Thin Film | P100DBCT-ND | ERA-3AEB101V | Panasonic Electronic Components | 6 | 0 | ERA-3AEB101V | TRUE | RES SMD 100 OHM 0.1% 1/10W 0603 | FALSE
R17 R18 R43 R103 R104 R232 R233 R332 R333 | 9 | 33 | I.52 | RES 33 OHM 1% 1/10W 0603 | RMCF0603FT33R0CT-ND | RMCF0603FT33R0 | Stackpole Electronics Inc | 9 | 0 | RMCF0603FT33R0 | TRUE | RES 33 OHM 1% 1/10W 0603 | TRUE
R27 R28 R37 R40 R44 R111 R112 R205 R206 R305 R306 | 11 | 3.3K | I.53 | 3.3 kOhms Â±1% 0.1W, 1/10W Chip Resistor 0603 (1608 Metric) Thin Film | YAG3354CT-ND | RT0603FRE073K3L | Yageo | 11 | 0 | RT0603FRE073K3L | TRUE | RES SMD 3.3K OHM 1% 1/10W 0603 | FALSE
R39 R113 R114 R131 R132 R213 R214 R215 R216 R313 R314 R315 R316 | 13 | 200K | I.54 | 200 kOhms Â±1% 0.1W, 1/10W Chip Resistor 0603 (1608 Metric) Thin Film | YAG5945CT-ND | RT0603FRE07200KL | Yageo | 13 | 0 | RT0603FRE07200KL | TRUE | RES SMD 200K OHM 1% 1/10W 0603 | FALSE
R21 R22 R23 R24 R25 R26 R42 R119 R217 R317 | 10 | 200 | I.55 | 200 Ohms Â±1% 0.125W, 1/8W Chip Resistor 0603 (1608 Metric) Anti-Sulfur, Moisture Resistant Thin Film | RNCP0603FTD200RCT-ND | RNCP0603FTD200R | Stackpole Electronics Inc | 10 | 0 | RNCP0603FTD200R | TRUE | RES 200 OHM 1% 1/8W 0603 | FALSE
R120 R121 R122 R123 R218 R219 R220 R221 R318 R319 R320 R321 | 12 | 10K | I.56 | RES SMD 10K OHM 0.1% 1/10W 0603 | P10KDBCT-ND | ERA-3AEB103V | Panasonic Electronic Components | 12 | 0 | ERA-3AEB103V | TRUE | RES SMD 10K OHM 0.1% 1/10W 0603 | TRUE
R127 R225 R325 | 3 | 243 | I.57 | 243 Ohms Â±0.1% 0.1W, 1/10W Chip Resistor 0603 (1608 Metric) Automotive AEC-Q200 Thin Film | P243DBCT-ND | ERA-3AEB2430V | Panasonic Electronic Components | 3 | 0 | ERA-3AEB2430V | TRUE | RES SMD 243 OHM 0.1% 1/10W 0603 | FALSE
U10 | 1 | 24LC256 | I.59 | IC EEPROM 256KBIT I2C 8MSOP | 24LC256T-I/MSCT-ND | 24LC256T-I/MS | Microchip Technology | 1 | 0 | 24LC256T-I/MS | TRUE | IC EEPROM 256KBIT I2C 8MSOP | TRUE
U11 | 1 | 74LVC1G384 | I.60 | IC SWITCH SPST 5TSOP | 1727-6075-1-ND | 74LVC1G384GV,125 | Nexperia USA Inc. | 1 | 0 | 74LVC1G384GV,125 | TRUE | IC SWITCH SPST 5TSOP | TRUE
R15 R16 R101 R102 R115 R116 R117 R118 R124 R125 R209 R210 R211 R212 R222 R223 R229 R230 R309 R310 R311 R312 R322 R323 R329 R330 | 26 | 10 | I.9 | RES SMD 10 OHM 5% 1/2W 0805 | 541-10TACT-ND | CRCW080510R0JNEAHP | Vishay Dale | 26 | 0 | CRCW080510R0JNEAHP | TRUE | RES SMD 10 OHM 5% 1/2W 0805 | TRUE
R38 | 1 | 0 | M.12 | RES 0 OHM JUMPER 1/10W 0603 | RMCF0603ZT0R00CT-ND | RMCF0603ZT0R00 | Stackpole Electronics Inc | 1 | 0 | RC0603JR-070RL | FALSE | RES SMD 0 OHM JUMPER 1/10W 0603 | FALSE
FB1 FB2 FB3 FB4 | 4 | 180 Ohm | M.36 | FERRITE BEAD 180 OHM 0805 1LN | 732-6123-1-ND | 74279220181 | WÃ¼rth Elektronik | 4 | 0 | 74279220181 | TRUE | FERRITE BEAD 180 OHM 0805 1LN | TRUE
C42 | 1 | 3.3 uF | M.6 | CAP FILM 3.3UF 5% 63VDC RADIAL | 399-9672-ND | R60DF4330506AJ | KEMET | 1 | 0 | R60DF4330506AJ | TRUE | CAP FILM 3.3UF 5% 63VDC RADIAL | TRUE
C101 C226 C326 | 3 | OPT |  | Do Not Populate |  | DNP |  | 0 | -3 | 0 | FALSE | 0 | FALSE
P1 | 1 | my_pcie_8x |  | Do Not Populate |  | DNP |  | 0 | -1 | 0 | FALSE | 0 | FALSE
R133 R231 R331 R601 | 4 | GND lift |  | Do Not Populate |  | DNP |  | 0 | -4 | 0 | FALSE | 0 | FALSE
TP1 | 1 | X+ |  | Do Not Populate |  | DNP |  | 0 | -1 | 0 | FALSE | 0 | FALSE
TP101 TP205 TP305 | 3 | DRL |  | Do Not Populate |  | DNP |  | 0 | -3 | 0 | FALSE | 0 | FALSE
TP102 TP206 TP306 | 3 | BUSY |  | Do Not Populate |  | DNP |  | 0 | -3 | 0 | FALSE | 0 | FALSE
TP103 TP209 TP309 | 3 | SDOA |  | Do Not Populate |  | DNP |  | 0 | -3 | 0 | FALSE | 0 | FALSE
TP105 TP201 TP301 | 3 | 0 |  | Do Not Populate |  | DNP |  | 0 | -3 | 0 | FALSE | 0 | FALSE
TP106 TP202 TP302 | 3 | 0 |  | Do Not Populate |  | DNP |  | 0 | -3 | 0 | FALSE | 0 | FALSE
TP107 TP203 TP303 | 3 | 0 |  | Do Not Populate |  | DNP |  | 0 | -3 | 0 | FALSE | 0 | FALSE
TP108 TP204 TP304 | 3 | 0 |  | Do Not Populate |  | DNP |  | 0 | -3 | 0 | FALSE | 0 | FALSE
TP109 TP207 TP307 | 3 | GND |  | Do Not Populate |  | DNP |  | 0 | -3 | 0 | FALSE | 0 | FALSE
TP110 TP208 TP308 | 3 | VREF |  | Do Not Populate |  | DNP |  | 0 | -3 | 0 | FALSE | 0 | FALSE
TP2 | 1 | X- |  | Do Not Populate |  | DNP |  | 0 | -1 | 0 | FALSE | 0 | FALSE
TP3 | 1 | SYNC |  | Do Not Populate |  | DNP |  | 0 | -1 | 0 | FALSE | 0 | FALSE
TP5 | 1 | VREF |  | Do Not Populate |  | DNP |  | 0 | -1 | 0 | FALSE | 0 | FALSE
TP6 | 1 | +3.3V |  | Do Not Populate |  | DNP |  | 0 | -1 | 0 | FALSE | 0 | FALSE
TP7 | 1 | +2.5V |  | Do Not Populate |  | DNP |  | 0 | -1 | 0 | FALSE | 0 | FALSE
TP8 | 1 | +8V |  | Do Not Populate |  | DNP |  | 0 | -1 | 0 | FALSE | 0 | FALSE
TP9 | 1 | -4V |  | Do Not Populate |  | DNP |  | 0 | -1 | 0 | FALSE | 0 | FALSE
TP9 | 1 | -4V |  | Do Not Populate |  | DNP |  | 0 | -1 | 0 | FALSE | 0 | FALSE
