robmacl/ilemt_hw/parts/ilemt_parts.xlsx

Manufacturer Part Number | Manufacturer | Digi-Key Part Number | Customer Reference | Unit Price | Description | Notes | Inventory
HHXD350ARA101MHA0G | United Chemi-Con | 565-HHXD350ARA101MHA0GCT-ND | P.6 | 0.89 | CAP ALUM HYBRD 100UF 20% 35V SMD
HHXD350ARA470MF80G | United Chemi-Con | 565-HHXD350ARA470MF80GCT-ND | D.5 | 0.67 | CAP ALUM HYBRID 47UF 20% 35V SMD
APXG160ARA331MH70G | United Chemi-Con | 565-4285-1-ND | I.19 | 0.95 | CAP ALUM POLY 330UF 20% 16V SMD |  | 7
CGA4J2C0G1H333J125AA | TDK Corporation | 445-6950-1-ND | I.37 | 0.34 | CAP CER 0.033UF 50V C0G 0805
CC0603KRX7R8BB104 | Yageo | 311-1341-1-ND | I.2 | 0.1 | CAP CER 0.1UF 25V X7R 0603 |  | 70
LLL185R71E103MA01L | Murata Electronics | 490-4315-1-ND | P.2 | 0.27 | CAP CER 10000PF 25V X7R 0306
GRM2195C1H103GA01D | Murata Electronics | 490-8296-1-ND | I.14 | 0.47 | CAP CER 10000PF 50V C0G/NP0 0805 |  | 7
C0603C103M5RACTU | KEMET | 399-7842-1-ND | P.5 | 0.1 | CAP CER 10000PF 50V X7R 0603
CC0805FRNPO0BN102 | Yageo | 311-3585-1-ND | I.1 | 0.215 | CAP CER 1000PF 100V NPO 0805
C0805C106K4PACTU | KEMET | 399-8012-1-ND | M.10 | 0.2 | CAP CER 10UF 16V X5R 0805 |  | 32
CL32B106KBJNNNE | Samsung Electro-Mechanics | 1276-3387-1-ND | P.4 | 0.415 | CAP CER 10UF 50V X7R 1210
06036D106MAT2A | AVX Corporation | 478-5318-1-ND | I.29 | 0.24 | CAP CER 10UF 6.3V X5R 0603
CL21B105KOFNNNG | Samsung Electro-Mechanics | 1276-6471-1-ND | I.27 | 0.03 | CAP CER 1UF 16V X7R 0805 |  | 35
GRM1885C1H222GA01D | Murata Electronics | 490-6381-1-ND | I.36 | 0.133 | CAP CER 2200PF 50V C0G/NP0 0603
CL10C221JB8NNNC | Samsung Electro-Mechanics | 1276-1048-1-ND | M.15 | 0.1 | CAP CER 220PF 50V C0G/NP0 0603 |  | 18
CC0805JKNPO9BN332 | Yageo | 311-4211-1-ND | I.45 | 0.4 | CAP CER 3300PF 50V NPO 0805
CC0603JRNPO9BN470 | Yageo | 311-1065-1-ND | I.44 | 0.1 | CAP CER 47PF 50V C0G/NPO 0603
C1210C476M4PACTU | KEMET | 399-5514-1-ND | M.11 | 1.06 | CAP CER 47UF 16V X5R 1210
C1210C476M9RACTU | KEMET | 399-5516-1-ND | I.28 | 1.16 | CAP CER 47UF 6.3V X7R 1210
GRM1885C1H562JA01D | Murata Electronics | 490-11471-1-ND | P14 | 0.18 | CAP CER 5600PF 50V C0G/NP0 0603
C2012C0G1H682J060AA | TDK Corporation | 445-7515-1-ND | I.46 | 0.22 | CAP CER 6800PF 50V C0G 0805
R60DF4330506AJ | KEMET | 399-9672-ND | M.6 | 0.91 | CAP FILM 3.3UF 5% 63VDC RADIAL |  | 0
R82EC1470DQ50J | KEMET | 399-5449-1-ND | D.3 | 0.177 | CAP FILM 4700PF 5% 100VDC RADIAL
DR331-475BE | Bourns Inc. | DR331-475BECT-ND | I.6 | 0.95 | CMC 4.7MH 200MA 2LN SMD
NRPN022MAMS-RC | Sullins Connector Solutions | S6009-02-ND | I.32 | 0.42 | CONN HEADER SMD 4POS 2MM
TSW-108-07-F-D | Samtec Inc. | SAM10854-ND | M.38 | 1.28 | CONN HEADER VERT 16POS 2.54MM
22232031 | Molex | WM4201-ND | D.31 | 0.24 | CONN HEADER VERT 3POS 2.54MM
39293046 | Molex | WM3844-ND | P.8 | 0.7 | CONN HEADER VERT 4POS 4.2MM
734151471 | Molex | WM5557-ND | I.35 | 2.83 | CONN MMCX JACK STR 50 OHM PCB
RJHSE5387 | Amphenol ICC (Commercial Products) | RJHSE5387-ND | I.18 | 1.58 | CONN MOD JACK 8P8C R/A SHIELDED
10018783-10102TLF | Amphenol ICC (FCI) | 609-1970-ND | M.2 | 1.08 | CONN PCI EXP FEMALE 98POS 0.039
61083-104400LF | Amphenol ICC (FCI) | 609-5949-ND | M.1 | 7.04 | CONN PLUG 100POS SMD GOLD
SSW-108-02-G-D | Samtec Inc. | SAM1214-08-ND | P.7 | 2.39 | CONN RCPT 16POS 0.1 GOLD PCB
39012040 | Molex | WM3701-ND | P.8.1 | 0.31 | CONN RECEPT 4POS DUAL
733910060 | Molex | WM5543-ND | D.29 | 3.14 | CONN SMA RCPT STR 50 OHM PCB
39000038 | Molex | WM2501CT-ND | P.8.2 | 0.1 | CONN SOCKET 18-24AWG CRIMP TIN
APXW003A0X3-SRZ | ABB Power Electronics Inc. | 555-1245-1-ND | P.1 | 9.27 | DC DC CONVERTER 3-18V 27W
BAS21SLT1G | ON Semiconductor | BAS21SLT1GOSCT-ND | I.43 | 0.163 | DIODE ARRAY GP 250V 225MA SOT23
BAV99-7-F | Diodes Incorporated | BAV99-FDICT-ND | D.30 | 0.14 | DIODE ARRAY GP 75V 300MA SOT23-3
74279220181 | Würth Elektronik | 732-6123-1-ND | M.36 | 0.32 | FERRITE BEAD 180 OHM 0805 1LN |  | 9
HZ0805C202R-10 | Laird-Signal Integrity Products | 240-2396-1-ND | I.5 | 0.18 | FERRITE BEAD 2 KOHM 0805 1LN
FBMJ2125HM210NT | Taiyo Yuden | 587-1765-1-ND | I.24 | 0.09 | FERRITE BEAD 21 OHM 0805 1LN
HI2220R301R-10 | Laird-Signal Integrity Products | 240-2430-1-ND | M.13 | 0.81 | FERRITE BEAD 300 OHM 2220 1LN
NRS5030T4R7MMGJV | Taiyo Yuden | 587-3605-1-ND | P.3 | 0.51 | FIXED IND 4.7UH 2.6A 45.5 MOHM
31.8201 | Schurter Inc. | 486-1258-ND | P.9 | 0.91 | FUSE BLOK CARTRIDGE 500V 10A PCB
0235003.MXP | Littelfuse Inc. | F4727-ND | P9.1 | 0.43 | FUSE GLASS 3A 250VAC 5X20MM
2036-07-SMLF | Bourns Inc. | 2036-07-SMLF-ND | I.8 | 1.92 | GDT 75V 10KA 3 POLE SMD
R30-1001102 | Harwin Inc. | 952-2312-ND | M.40 | 0.48 | HEX STANDOFF M3X0.5 BRASS 11MM
V6621B | Assmann WSW Components | AE10787-ND | M.39 | 0.34 | HEX STANDOFF M3X0.5 BRASS 8MM
LTC2512CDKD-24#PBF | Analog Devices Inc. | LTC2512CDKD-24#PBF-ND | I.3 | 24.1 | IC ADC 24BIT SAR 24DFN
OPA1611AIDR | Texas Instruments | 296-47811-1-ND | D.2 | 4.08 | IC AUDIO 1 CIRCUIT 8SOIC
OPA1679IDR | Texas Instruments | 296-46621-1-ND | I.31 | 1.16 | IC AUDIO 4 CIRCUIT 14SOIC
SN74LVC541ADBR | Texas Instruments | 296-8518-1-ND | I.11 | 0.53 | IC BUF NON-INVERT 3.6V 20SSOP |  | 2
DAC80004IPW | Texas Instruments | 296-44598-5-ND | M.8 | 17.72 | IC DAC 16BIT V-OUT 14TSSOP
PCM1794ADBR | Texas Instruments | 296-21537-1-ND | D.4 | 13.08 | IC DAC/AUDIO 24BIT 200K 28SSOP
FIN1047MTCX | ON Semiconductor | FIN1047MTCXFSCT-ND | I.38 | 1.62 | IC DRIVER 4/0 16TSSOP
74AUP1G74DC,125 | Nexperia USA Inc. | 1727-6029-1-ND | M.3 | 0.48 | IC FF D-TYPE SNGL 1BIT 8VSSOP |  | 2
THS4131CDR | Texas Instruments | 296-46339-1-ND | I.42 | 6.97 | IC OPAMP DIFF 1 CIRCUIT 8SOIC
OPA27GU/2K5 | Texas Instruments | 296-31706-1-ND | I.15 | 3.07 | IC OPAMP GP 1 CIRCUIT 8SOIC
OPA209AID | Texas Instruments | 296-28030-5-ND | M.5 | 3.08 | IC OPAMP GP 1 CIRCUIT 8SOIC
OPA2210IDR | Texas Instruments | 296-OPA2210IDRCT-ND | D.1 | 4.31 | IC OPAMP GP 2 CIRCUIT 8SOIC
AD8599ARZ | Analog Devices Inc. | AD8599ARZ-ND | I.12 | 8.19 | IC OPAMP GP 2 CIRCUIT 8SOIC
OPA830ID | Texas Instruments | 296-17400-5-ND | I.20 | 2.86 | IC OPAMP VFB 1 CIRCUIT 8SOIC
DS90LV048ATMTC/NOPB | Texas Instruments | DS90LV048ATMTC/NOPB-ND | I.39 | 3.05 | IC RECEIVER 0/4 16TSSOP |  | 2
MCP1755S-3302E/DB | Microchip Technology | MCP1755S-3302E/DB-ND | I.25 | 0.66 | IC REG LIN 3.3V 300MA SOT223-3 |  | 1
LM337IMPX/NOPB | Texas Instruments | LM337IMPX/NOPBCT-ND | D.6 | 1.58 | IC REG LIN NEG ADJ 1A SOT223-4
AP7361C-25SP-13 | Diodes Incorporated | AP7361C-25SP-13DICT-ND | M.7 | 0.64 | IC REG LINEAR 2.5V 1A 8SO
MCP1755S-5002E/DB | Microchip Technology | MCP1755S-5002E/DB-ND | M.9 | 0.66 | IC REG LINEAR 5V 300MA SOT223-3
NCP1117STAT3G | ON Semiconductor | NCP1117STAT3GOSCT-ND | I.26 | 0.45 | IC REG LINEAR POS ADJ 1A SOT223 |  | 2
MAX6220ASA-5.0+ | Maxim Integrated | MAX6220ASA-5.0+-ND | M.4 | 3.97 | IC VREF SERIES 0.1% 8SOIC
150060VS55040 | Würth Elektronik | 732-12017-1-ND | M.37 | 0.18 | LED GREEN DIFFUSED 0603 SMD
0ZCJ0075AF2E | Bel Fuse Inc. | 507-1805-1-ND | I.21 | 0.17 | PTC RESET FUSE 16V 750MA 1206
RMCF0603ZT0R00 | Stackpole Electronics Inc | RMCF0603ZT0R00CT-ND | M.12 | 0.1 | RES 0 OHM JUMPER 1/10W 0603 |  | 96
RL1206FR-070R068L | Yageo | 311-.068LWCT-ND | I.10 | 0.46 | RES 0.068 OHM 1% 1/4W 1206
RNCP0603FTD1K50 | Stackpole Electronics Inc | RNCP0603FTD1K50CT-ND | M.32 | 0.1 | RES 1.5K OHM 1% 1/8W 0603
RMCF0603FT1K74 | Stackpole Electronics Inc | RMCF0603FT1K74CT-ND | D.33 | 0.1 | RES 1.74K OHM 1% 1/10W 0603
RNCP0603FTD10R0 | Stackpole Electronics Inc | RNCP0603FTD10R0CT-ND | I.9 | 0.1 | RES 10 OHM 1% 1/8W 0603
RNCP0603FTD100R | Stackpole Electronics Inc | RNCP0603FTD100RCT-ND | M.29 | 0.1 | RES 100 OHM 1% 1/8W 0603 |  | 1
RNCP0603FTD1K00 | Stackpole Electronics Inc | RNCP0603FTD1K00CT-ND | M.31 | 0.1 | RES 1K OHM 1% 1/8W 0603 |  | 4
RK73H2BTTD2R74F | KOA Speer Electronics, Inc. | 2019-RK73H2BTTD2R74FCT-ND | I.16 | 0.1 | RES 2.74 OHM 1% 1/4W 1206
RNCP0603FTD200R | Stackpole Electronics Inc | RNCP0603FTD200RCT-ND | I.55 | 0.1 | RES 200 OHM 1% 1/8W 0603 |  | 8
ERA-6AEB202V | Panasonic Electronic Components | P2.0KDACT-ND | I.17 | 0.31 | RES 2K OHM 0.1% 1/8W 0805 |  | 0
RNCP0603FTD301R | Stackpole Electronics Inc | RNCP0603FTD301RCT-ND | I.50 | 0.1 | RES 301 OHM 1% 1/8W 0603
RMCF0603FT33R0 | Stackpole Electronics Inc | RMCF0603FT33R0CT-ND | I.52 | 0.1 | RES 33 OHM 1% 1/10W 0603
RNCP0603FTD392R | Stackpole Electronics Inc | RNCP0603FTD392RCT-ND | I.49 | 0.1 | RES 392 OHM 1% 1/8W 0603
RNCP0603FTD4K99 | Stackpole Electronics Inc | RNCP0603FTD4K99CT-ND | M.34 | 0.1 | RES 4.99K OHM 1% 1/8W 0603
RNCP0603FTD40K2 | Stackpole Electronics Inc | RNCP0603FTD40K2CT-ND | M.14 | 0.1 | RES 40.2K OHM 1% 1/8W 0603
MCT06030C6200FP500 | Vishay Beyschlag/Draloric/BC Components | 749-1752-1-ND | D.35 | 0.16 | RES 620 OHM 1% 1/8W 0603
RMCF0603FT7K32 | Stackpole Electronics Inc | 738-RMCF0603FT7K32CT-ND | D.36 | 0.1 | RES 7.32K OHM 1% 1/10W 0603
CAY16-330J4LF | Bourns Inc. | CAY16-330J4LFCT-ND | I.13 | 0.1 | RES ARRAY 4 RES 33 OHM 1206 |  | 2
ESR10EZPJ100 | Rohm Semiconductor | RHM10KCT-ND | I.9 | 0.072 | RES SMD 10 OHM 5% 0.4W 0805
CRCW080510R0JNEAHP | Vishay Dale | 541-10TACT-ND | I.9 | 0.176 | RES SMD 10 OHM 5% 1/2W 0805 | Out of stock | 97
ERA-3AEB101V | Panasonic Electronic Components | P100DBCT-ND | I.51 | 0.31 | RES SMD 100 OHM 0.1% 1/10W 0603
ERA-3AEB103V | Panasonic Electronic Components | P10KDBCT-ND | I.56 | 0.31 | RES SMD 10K OHM 0.1% 1/10W 0603 |  | 6
CRCW060313K3FKEA | Vishay Dale | 541-13.3KHCT-ND | P12 | 0.1 | RES SMD 13.3K OHM 1% 1/10W 0603
CRCW060316K2FKEA | Vishay Dale | 541-16.2KHCT-ND | P10 | 0.1 | RES SMD 16.2K OHM 1% 1/10W 0603
ERA-3AEB102V | Panasonic Electronic Components | P1.0KDBCT-ND | I.48 | 0.26 | RES SMD 1K OHM 0.1% 1/10W 0603
RT0603FRE07200KL | Yageo | YAG5945CT-ND | I.54 | 0.056 | RES SMD 200K OHM 1% 1/10W 0603
ERA-3AEB2430V | Panasonic Electronic Components | P243DBCT-ND | I.57 | 0.31 | RES SMD 243 OHM 0.1% 1/10W 0603
CRCW0603270RFKEA | Vishay Dale | 541-270HCT-ND | P13 | 0.1 | RES SMD 270 OHM 1% 1/10W 0603
RT0603FRE073K3L | Yageo | YAG3354CT-ND | I.53 | 0.1 | RES SMD 3.3K OHM 1% 1/10W 0603
8-2176091-9 | TE Connectivity Passive Product | A110514CT-ND | I.30 | 0.494 | RES SMD 499 OHM 0.1% 1/4W 0805
RT0603DRE07698RL | Yageo | 311-2653-1-ND | I.47 | 0.1 | RES SMD 698 OHM 0.5% 1/10W 0603
CR0603-FX-7501ELF | Bourns Inc. | CR0603-FX-7501ELFCT-ND | P11 | 0.1 | RES SMD 7.5K OHM 1% 1/10W 0603
ERA-3AED822V | Panasonic Electronic Components | P123782CT-ND | D.38 | 0.1 | RES SMD 8.2K OHM 0.5% 1/10W 0603
MCT06030C8200FP500 | Vishay Beyschlag/Draloric/BC Components | 749-1683-1-ND | D.34 | 0.132 | RES SMD 820 OHM 1% 1/8W 0603
1540-2 | Keystone Electronics | 36-1540-2-ND | I.33 | 0.5 | TERM TURRET HOLLOW L=6.75MM TIN |  | 16
2STD1665T4 | STMicroelectronics | 497-5236-1-ND | I.22 | 0.87 | TRANS NPN 65V 6A DPAK |  | 2
NSS1C300ET4G | ON Semiconductor | NSS1C300ET4GOSCT-ND | I.23 | 0.64 | TRANS PNP 100V 3A 3DPAK
P4SMA12A-E3/61 | Vishay Semiconductor Diodes Division | P4SMA12A-E3/61GICT-ND | I.41 | 0.35 | TVS DIODE 10.2V 16.7V DO214AC
SMAJ15A-13-F | Diodes Incorporated | SMAJ15A-FDICT-ND | D.39 | 0.37 | TVS DIODE 15V 24.4V SMA
824500500 | Würth Elektronik | 732-9974-1-ND | I.40 | 0.27 | TVS DIODE 5V 9.2V DO214AC |  | 2
CDSOD323-T08L | Bourns Inc. | CDSOD323-T08LCT-ND | I.58 | 0.71 | TVS DIODE 8V 18.3V SOD323
570CAC000121DG | Silicon Labs | 336-2519-ND | M.19 | 12.47 | XTAL OSC XO 100.0000MHZ CMOS SMD
