robmacl/ilemt_hw/coils/emoto/components/3DV09_sensor_assy.SLDASM

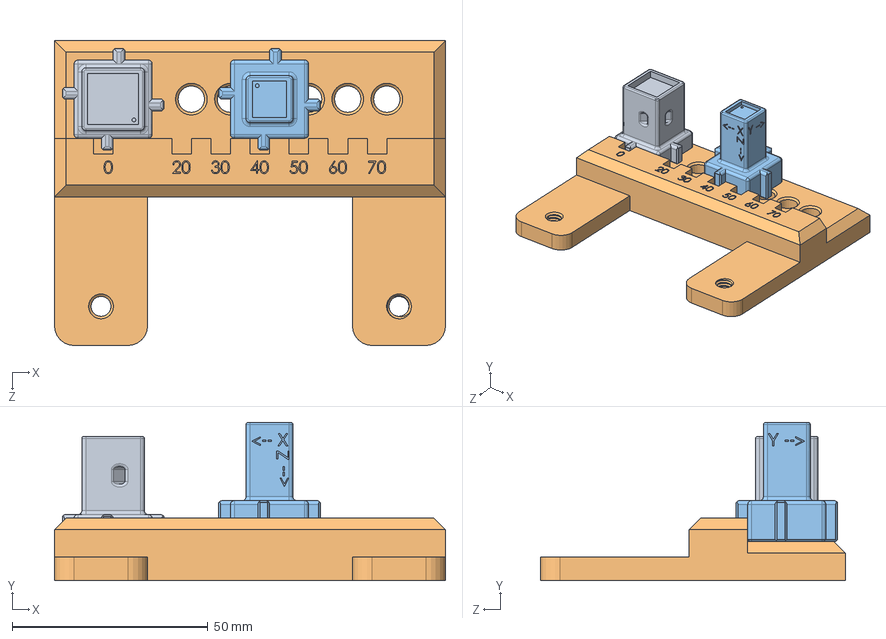
[picture p5: CAD file, 2026-09-15]
coils/emoto/components/3DV09_sensor_assy.SLDASM
100.0 x 40.4 x 78.0 mm
3DV09_sensor_holder
1dof_cal_base
3DCC08_source_holder
