robmacl/ilemt_hw/coils/source/bobbin_print.SLDASM

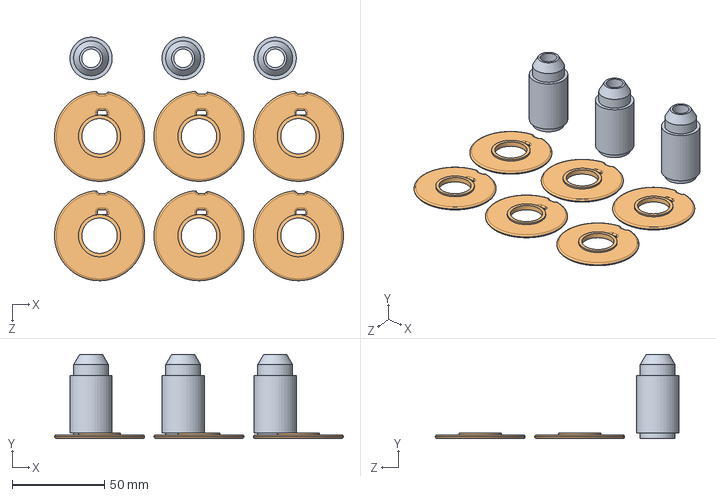
[picture p6: CAD file, 2019-12-10]
coils/source/bobbin_print.SLDASM
157.0 x 45.7 x 132.3 mm
source_core x 3
cheek x 6
