robmacl/ilemt_hw/coils/source/bobbin.SLDASM

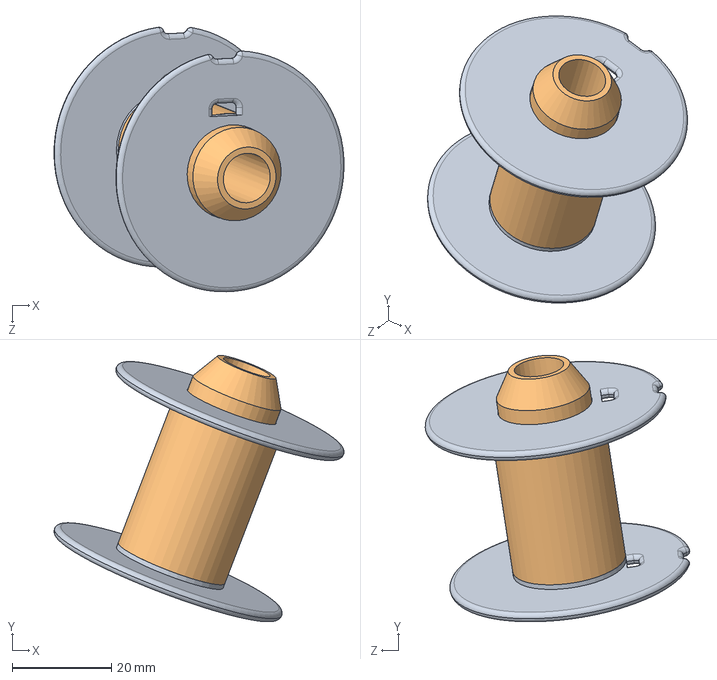
[picture p7: CAD file, 2019-12-10]
coils/source/bobbin.SLDASM
58.4 x 53.6 x 53.3 mm
cheek x 2
source_core
