robmacl/ilemt_hw/coils/emoto/3DV09_sensor_holder.SLDPRT

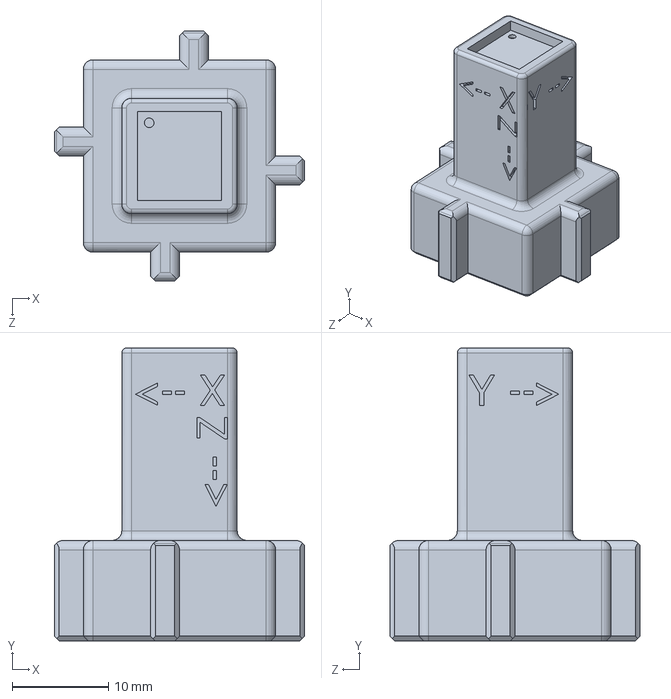
[picture p8: CAD file, 2026-09-15]
coils/emoto/3DV09_sensor_holder.SLDPRT
26.0 x 30.4 x 26.0 mm
