robmacl/ilemt_hw/coils/premo_165mm/cap.SLDPRT

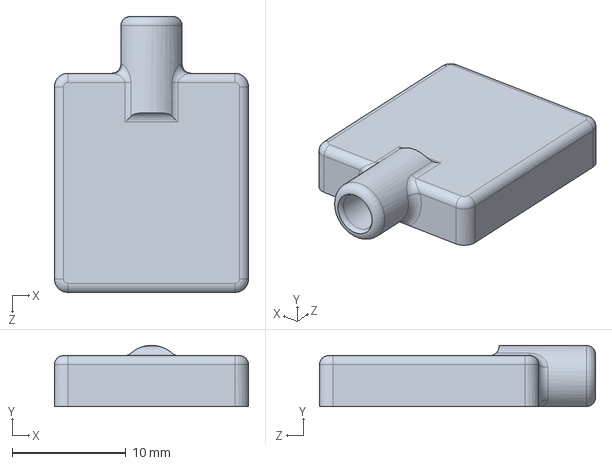
[picture p9: CAD file, 2022-10-27]
coils/premo_165mm/cap.SLDPRT
17.1 x 5.40 x 24.3 mm
