robmacl/ilemt_hw/coils/sensor/3D_guidance_sensor_clamp.SLDPRT

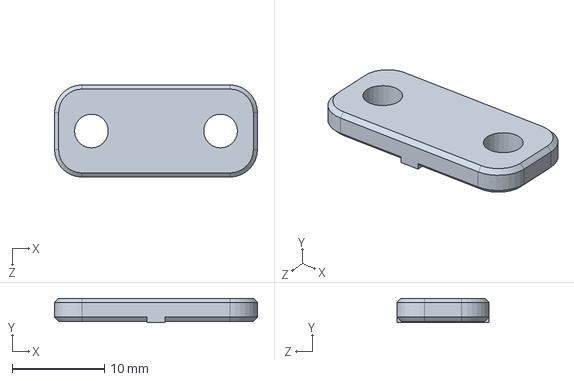
[picture p10: CAD file, 2022-08-03]
coils/sensor/3D_guidance_sensor_clamp.SLDPRT
22.0 x 2.65 x 10.0 mm
