robmacl/ilemt_hw/coils/emoto/1dof_cal_base.SLDPRT

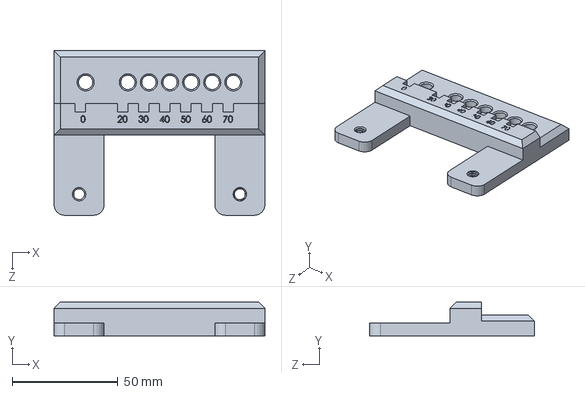
[picture p11: CAD file, 2026-09-15]
coils/emoto/1dof_cal_base.SLDPRT
100.0 x 16.0 x 78.0 mm
