robmacl/ilemt_hw/coils/emoto/components/3DCC08.step

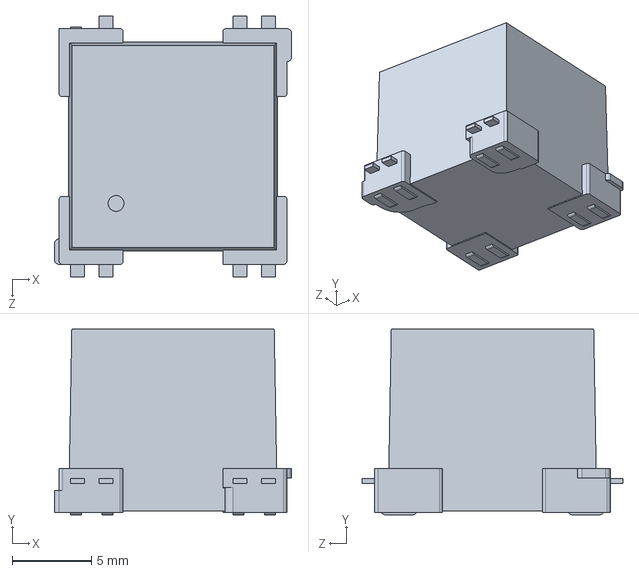
[picture p12: CAD file, 2026-09-15]
coils/emoto/components/3DCC08.step
15.0 x 11.8 x 16.5 mm
