robmacl/ilemt_hw/coils/source/cheek.SLDPRT

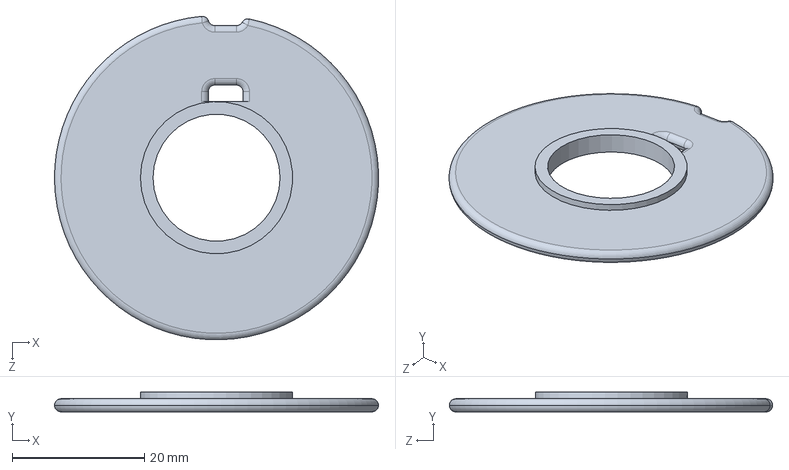
[picture p13: CAD file, 2019-12-10]
coils/source/cheek.SLDPRT
49.0 x 3.00 x 48.9 mm
