robmacl/ilemt_hw/coils/emoto/3DCC08_source_holder.SLDPRT

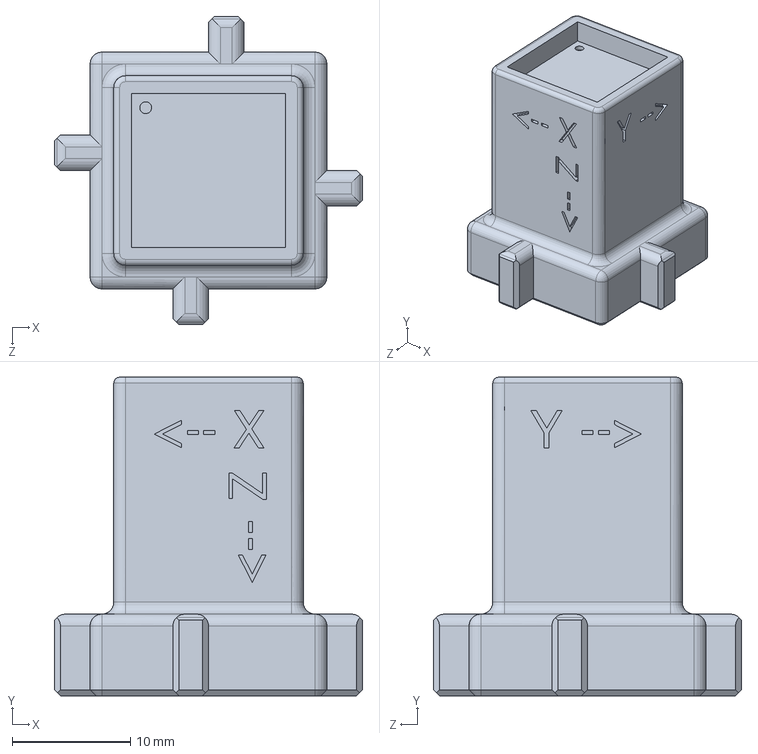
[picture p14: CAD file, 2026-09-15]
coils/emoto/3DCC08_source_holder.SLDPRT
26.0 x 26.9 x 26.0 mm
