robmacl/ilemt_hw/coils/emoto/components/3DC09LP.step

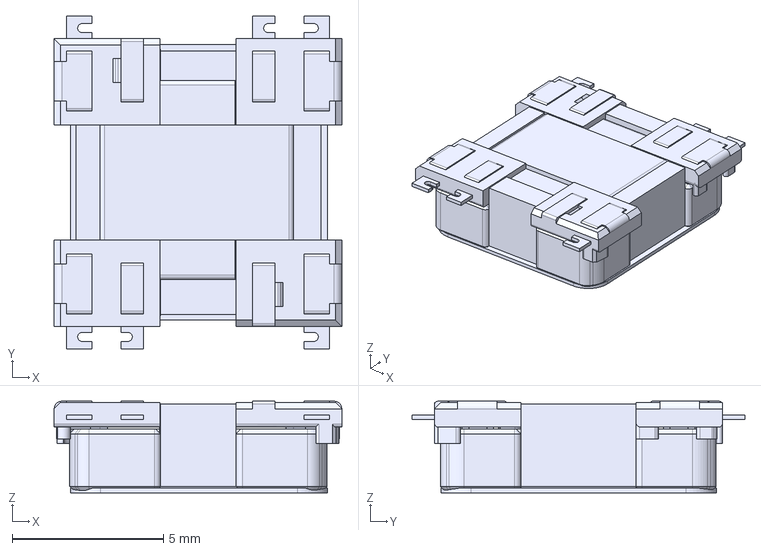
[picture p15: CAD file, 2026-09-15]
coils/emoto/components/3DC09LP.step
9.50 x 11.0 x 3.03 mm
