robmacl/ilemt_hw/coils/source/source_winding.SLDPRT

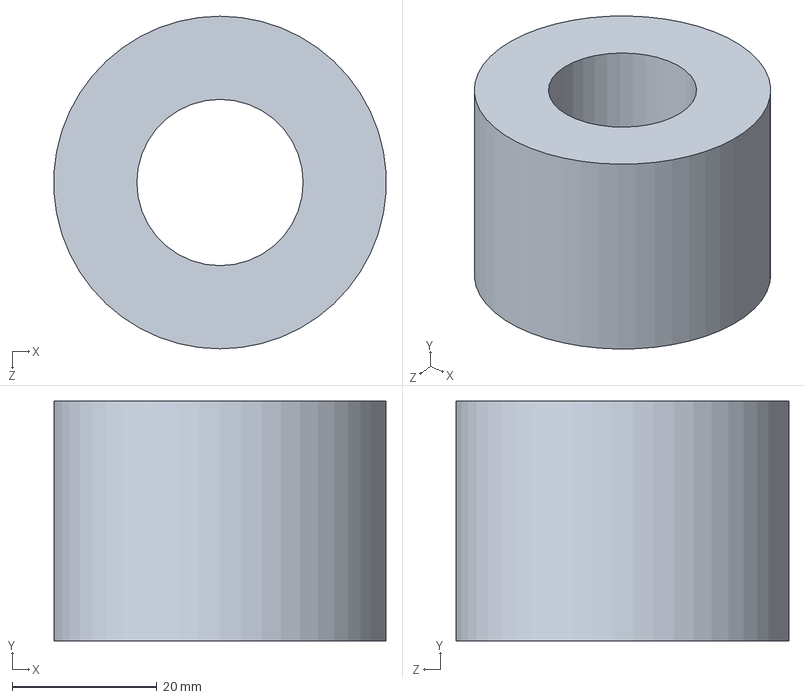
[picture p16: CAD file, 2019-12-10]
coils/source/source_winding.SLDPRT
45.9 x 33.1 x 46.0 mm
