robmacl/ilemt_hw/coils/source/source_core.SLDPRT

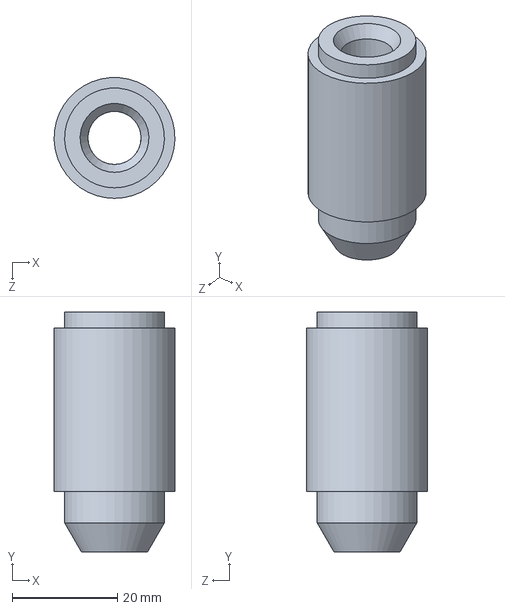
[picture p17: CAD file, 2019-12-10]
coils/source/source_core.SLDPRT
23.0 x 45.7 x 23.0 mm
