robmacl/ilemt_hw/(list of files, cad)

Other CAD files:
coils/emoto/components/3DC09LP.SLDPRT
