robmacl/ilemt_hw/prototype/pdf/bud_sb2143.pdf

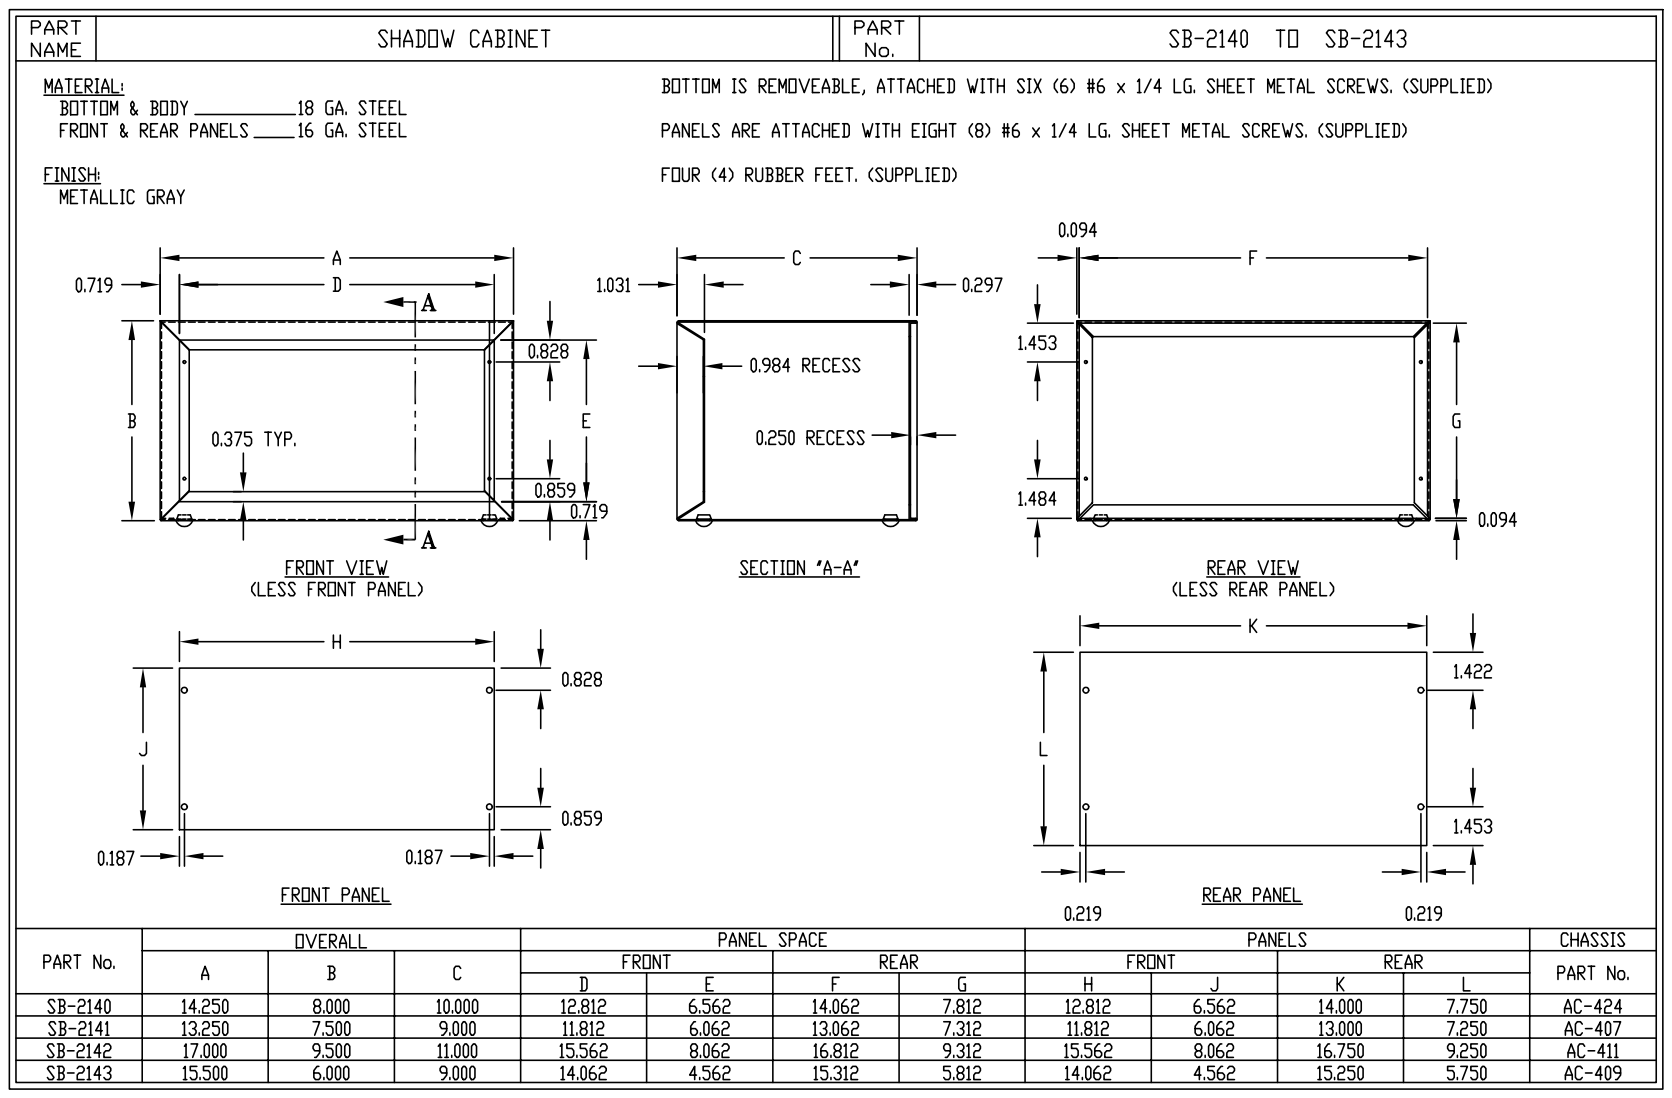
[picture p18: page 1]
