robmacl/ilemt_hw/(commit log)

2019-12-01 Initial checkin of work on input board.
    [adc.sch, antialias.sch, in_amp.sch, in_filter.sch, input.kicad_pcb, input.sch]
2019-12-05 Work on schematics for antialias_driver.sch and in_filter.sch. Spice simulations of antialias filter and reference driver.
    [adc.sch, antialias_driver.sch, in_filter.sch, input.sch]
2019-12-10 Continuing work on input board, also added some design files and PDF documentation for the prototype source and sensor. Deleted various spurious kicad project files. The main project for the input bo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
    [adc.sch, antialias.sch, antialias_driver.sch, bobbin.SLDASM, bobbin_print.SLDASM, cheek.SLDPRT, in_amp.sch, in_filter.sch]
2019-12-10 Added notebook.txt, several years of notes on ILEMT development, hardware and the prototype labview signal processing.
2019-12-20 More work on input board
    [adc.sch, antialias_driver.sch, in_board.sch, input_channel.sch]
2019-12-20 More file renaming
    [input_board.kicad_pcb, input_board.sch]
2020-01-07 Mainly work on the top level of the input board, attaching signals to the channels, digital I/O. Decided to use Eurocard 64 pin type B connector for the connection to the main board. See input_board_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
    [adc.sch, antialias_driver.sch, board_connector.sch, in_amp.sch, in_filter.sch, input_board.sch, input_channel.sch, input_channel_dummy.sch]
2020-01-10 Still beating into overall shape. This is a checkpoint before modifying the analog signal chain to fold the diff amp and antialias into the driver, going to a full differential path.
    Overall: Changes to component attributes to reduce duplicates in BOM, and added links to Digikey and datasheets.
    board_connector.sch: Added reference input pins, decimation SEL lines.
    in_filter.sch:
    Fixed BIST feedback to be taken at the top of each injection resistor (4 lines, not 2)
    input_board.sch:
    Added some missing connections and no-connects.
    power_budget.xlsx:
    Much more elaborate now, models effect of input levels on load currents, computes currents and total power, for several variants.
    reference_b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
    [adc.sch, antialias_driver.sch, board_connector.sch, in_amp.sch, in_filter.sch, input_board.sch, power_budget.xlsx, reference_buffer.sch]
2020-01-14 Changes mostly related to avoiding excess power consumption. This is mainly by limiting the signal swing to 0..5V and using asymmetric supplies of -4V and +8V. (Perhaps we can reduce these to 3/7 V.)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
    power_budget.xlsx
    power.sch
    reference_buffer.sch:
    Changes related to the new supply voltages, and start on the power supply section.
    input_channel.sch
    in_amp.sch
    antialias_driver.sch:
    Reworked the input signal chain to keep a full differential path, rolling the antialias filter
    into the ADC driver. Also, related to change to lower asymmetrical supply voltages, there is
    no 20V PP anywhere (the this was for benefit of the antialias filte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
    [adc.sch, antialias_driver.sch, board_connector.sch, in_amp.sch, in_filter.sch, input_board.sch, input_channel.sch, input_channel_dummy.sch]
2020-01-17 Mostly work on power, regulators and distribution. Also more BOM cleanup.
    All of the bypass capacitors are now spec'd and in the DigiKey BOM. TVS zeners are now
    spec'd. Folded together some resistor values and got rid of some 1206 parts that no longer
    need that much power rating at the lower supplies.
    A affecting all of the input channel sheets is that we now distribute filtered V+, V- and VREF
    via sheet ports. The V+, V- filter is on input_channel.sch and the VREF filter is still in
    adc.sch, but is distributed out to the other sheets that need it.
    bist_buffer.sch: added buffer for built-in self-test
    board_connector.sch: put the input filter for the analog supplies here.
    power.sch: ad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
    [adc.sch, antialias_driver.sch, bist_buffer.sch, board_connector.sch, in_amp.sch, in_filter.sch, input_board.sch, input_channel.sch]
2020-01-18 Mostly finished wiring.
    Finished mapping pins in board_connector.sch. Renamed some nets and moved the analog
    supply filter to power.sch. Added probe_connector.sch which now includes input protected
    on the probe calibration one-wire line. The configuration digital interface stuff is still
    sketchy, this is basically a placeholder. Eventually we will have an I2C I/O extender for
    configuration and calibration memory, but for now I added a jumper header for setting the
    SEL0/SEL1 lines to control the ADC decimation.
    [adc.sch, antialias_driver.sch, bist_buffer.sch, board_connector.sch, in_amp.sch, in_filter.sch, input_board.sch, input_channel.sch]
2020-01-21 Cleanup to get ready to start board layout. I had to get rid off all the bus signals, since in Kicad busses don't work that way. Added a couple testpoints; many more needed.
    Work on component placement in PCB. I changed DGND to plain GND and "protective earth" to
    "earth" (for chassis ground). Chassis ground is now connected on the board only via a capacitor.
    I had to fix the connector footprint to match the pin numbers on the symbol (there was a case
    difference).
    [adc.sch, antialias_driver.sch, bist_buffer.sch, board_connector.sch, in_amp.sch, in_filter.sch, input_board.kicad_pcb, input_board.sch]
2020-01-23 Progress on input board layout. Have adopted 100x280mm eurocard format with connector at the back. Schematic changes are mostly cosmetic. The working board file is now input/input_board_rear.kicad_pcb
    [adc.sch, input_board_rear.kicad_pcb, input_channel.sch, input_channel_dummy.sch, power.sch]
2020-01-28 Changed board connector to PCIe 8x, added test points, cleanup of component values. Add LVDS Rx termination, bypass caps.
    [adc.sch, antialias_driver.sch, bist_buffer.sch, board_connector.sch, in_amp.sch, in_filter.sch, input_board.kicad_pcb, input_board.sch]
2020-01-30 Checkpoint before starting routing. Added power and ground testpoints.
    [adc.sch, antialias_driver.sch, bist_buffer.sch, board_connector.sch, in_amp.sch, in_filter.sch, input_board.kicad_pcb, input_board.sch]
2020-02-04 Lots of work on routing input_board.kicad_pcb, not done yet.
    [adc.sch, in_amp.sch, input_board.kicad_pcb, input_board.sch]
2020-02-07 Minor tweaks to schematic, and ongoing progress on PCB layout.
    Changed BIST buffer to run off of CHAN1_V+, not the global V+. This caused the CHAN_V+ net name to change.
    On power.sch, added bypass caps for the VREF inputs to the V+/V- regulators. Also, the BIST input lines now
    have an RC filter, not just a resistor.
    [bist_buffer.sch, input_board.kicad_pcb, input_board.sch, input_channel.sch, power.sch]
2020-02-11 Snapshot before replicating input channels
    [adc.sch, antialias_driver.sch, bist_buffer.sch, board_connector.sch, in_amp.sch, in_filter.sch, input_board.kicad_pcb, input_board.sch]
2020-02-14 Input board is nearly ready to send off for the first spin.
    [adc.sch, antialias_driver.sch, bist_buffer.sch, in_amp.sch, in_filter.sch, input_board.kicad_pcb, input_board.sch, input_channel.sch]
2020-02-17 Changed the input TVS from 12V bidirectional to 8V unidirectional, board tweaks
    [in_filter.sch, input_board.kicad_pcb]
2020-02-18 Various tweaks to schematic which help in the PCB view, mainly getting informative net names. Also unscrambled the + and - paths in the input channel. This avoided a cross-over before the first stage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
    Getting better net names made it easier to review the PCB to see if it made sense. I checked
    the ICs on the PCB against the datasheet pinout, and while doing this fixed an actual bug where
    I had BIST-+ and BIST+-swapped.
    I made some tweaks on the PCB to try to equalize the copper area on the input nets so as to
    match the capacitance. I tweaked the top-side ground pours somewhat, adding in the regulator
    area, removi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
    [adc.sch, antialias_driver.sch, bist_buffer.sch, board_connector.sch, in_amp.sch, in_filter.sch, input_board.kicad_pcb, input_channel.sch]
2020-02-21 Fixed footprints for U5 and RN1/RN2. Added gerber files for input board. Start of work on the main board.
    [clock.sch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]
2020-02-21 Added mounting holes
    [input_board-B_Cu.gbr, input_board-B_Mask.gbr, input_board-B_SilkS.gbr, input_board-Edge_Cuts.gbr, input_board-F_Cu.gbr, input_board-F_Mask.gbr, input_board-F_Paste.gbr, input_board-F_SilkS.gbr]
2020-03-27 Work on main board.
    [BIST.sch, MicroZed JX pinout tables 151110.xlsx, adc.sch, antialias_driver.sch, bist_buffer.sch, board_connector.sch, clock.sch, in_amp.sch]
2020-04-16 Checkpoint of state before I start schematic revisions for the next version of the input board. There are not any substantive modifications to the input board, but some broad changes in component att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
    [adc.sch, antialias_driver.sch, bist_buffer.sch, card_slot.sch, in_amp.sch, in_filter.sch, input_board.kicad_pcb, input_board.sch]
2020-04-29 Add lowpass filter to input board reference buffer, and fix antialias frequency response. Supply and reference testing in notebook.txt, lots of discussion of reference noise.
    [BIST.sch, antialias_driver.sch, bist_buffer.sch, card_slot.sch, clock.sch, in_amp.sch, in_filter.sch, input_board.kicad_pcb]
2020-05-28 A bunch of thinking about RFI and ESD, and some testing. Mostly reflected in notebook.txt. Also another more explicit round of consideration of box-level grounding and power distribution, because thi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
    in_filter.sxsch: added simulation of ESD, use vendor models for TVS diode and ferrite.
    power_budget.xlsx: get rid of sheets for the input boards not implemented. Add sheet for
    the main board and carry over data from the input board sheet.
    [adc.sch, antialias_driver.sch, card_slot.sch, clock.sch, in_filter.sch, main_board.kicad_pcb, main_board.sch, output_slot.sch]
2020-05-29 Diffs mainly due to first annotation of some new components. Also changes on power.sch, added TVS and some caps.
    [card_slot.sch, output_slot.sch, power.sch, reference.sch]
2020-06-10 Mostly work on hooking in the Microzed using kipart symbols and a footprint. Also added 2.5V VCCIO regulator.
    [AP3761C-xxSP.csv, BIST.sch, MicroZed JX pinout tables 151110.xlsx, card_slot.sch, clock.sch, input_slots.sch, kipart_microzed.csv, main_board.kicad_pcb]
2020-06-13 Updated for new microzed pin mapping scheme.
    [input_slots.sch, kipart_microzed.csv, main_board.kicad_pcb, main_board.sch, microzed.sch, output_slot.sch]
2020-06-14 Schematic is mostly complete (except for BIST DACs), and passes ERC. Rough placement of components on PCB.
    [card_slot.sch, clock.sch, input_slots.sch, main_board.kicad_pcb, microzed.sch, output_slot.sch, power.sch, reference.sch]
2020-06-20 Mechanical feature layout on main board (edge connector and mount hole locations). Added some dimension callouts to the input board. Tweaked grounding on main board schematic. Chassis ground is not c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
    [BIST.sch, bist_buffer.sch, card_slot.sch, in_filter.sch, input_board.kicad_pcb, input_slots.sch, main_board.kicad_pcb, power.sch]
2020-07-01 Mostly work on main board layout. Aligned things on mm grid for easier routing, moved things around to create routing area. Neatened up component groups onto the grid. Parts of the routing plan are n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
    [card_slot.sch, clock.sch, input_slots.sch, main_board.kicad_pcb, microzed.sch, output_slot.sch, power.sch]
2020-07-06 Changes related to pin mapping. There's a new BIST unit in the Microzed symbol, and the unit ordering has changed. I also added SDI lines to the input slots which could be used to configure the ADC i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
    [BIST.sch, card_slot.sch, input_slots.sch, main_board.kicad_pcb, main_board.sch, microzed.sch, output_slot.sch, reference.sch]
2020-07-08 Various preparations for routing the main board. Cleaned up the BOM and reconciled it with the Digikey BOM, so lots of component attributes have changed. This involved pinning down some components wh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
    [BIST.sch, card_slot.sch, clock.sch, input_slots.sch, main_board.kicad_pcb, microzed.sch, output_slot.sch, power.sch]
2020-07-15 Main board is now fully routed and passing DRC. Minor changes related to pin remapping. I2C and one-wire pullups are to OVDD 3.3V, not VCCIO 2.5V. Changes to supply decoupling and VREF- net in refere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
    [clock.sch, input_slots.sch, main_board.kicad_pcb, microzed.sch, reference.sch]
2020-07-17 Added testpoints, debug IO port, LEDs, and clock output jack.
    [BIST.sch, card_slot.sch, clock.sch, input_slots.sch, main_board.kicad_pcb, microzed.sch, output_slot.sch, power.sch]
2020-07-22 Finishing up main/main_board/main_board.kicad_pcb. Test points, stiching vias, ground pours.
    [BIST.sch, clock.sch, input_board_bom.csv, main_board.kicad_pcb, main_cart.xlsx, microzed.sch, power.sch]
2020-07-24 Main board seems to be about ready to be set off. Added gerber files. Made new footprints for the LEDs and DAC, since nothing in the standard footprints was a good match for the manufacturer recommen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
    [BIST.sch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]
2020-07-24 I added a bypass cap on the BIST DAC reference input. Though not required on the datasheet, it seems like a good idea because the bandwidth at the reference input is 350 kHz.
    [BIST.sch, card_slot.sch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]
2020-07-28 Mostly start of work on the lv_regs project for the low-voltage regulator daughtercard to the main board. Also made a directory with the revision 0 main board output files. Where the files are locate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
    [ge_prolynx.csv, lv_regs.kicad_pcb, lv_regs.sch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]
2020-07-31 A near final version of the low-volt regulator board. Pending footprint comparison on the actual parts.
    [lv_regs.kicad_pcb, lv_regs.sch, main_board.kicad_pcb, reg_neg.sch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]
2020-09-26 notebook.txt and tweaks to comments in input board (no circuit changes).
    [board_connector.sch, input_board.sch, power.sch, reference_buffer.sch]
2020-10-03 Started doc.txt, which is a place to put documentation of the current state of the system, especially procedures. This had been at the start of notebook.txt.
2020-10-06 Start on schematic for DAC board. Ripping stuff from the input board supply and reference buffer.
    [dac.kicad_pcb, dac.sch, power.sch, reference_buffer.sch]
2020-10-08 More work on dac/power.sch and dac/reference_buffer.sch. Also, fixed comments in input/reference_buffer.sch
    [power.sch, reference_buffer.sch]
2020-10-16 Much progress on the DAC card. Schematic is complete, starting on placement.
    [dac.kicad_pcb, dac.sch, dac_board.kicad_pcb, dac_board.sch, edge_connector.sch, interface.sch, iv_stage.sch, out_chan.sch]
2020-10-21 DAC board is routed. I also changed the digital interface to use a buffer (like I did on the input board) so that everything is buffered and we don't have multi-drop nets.
    [dac.sch, dac_board.kicad_pcb, dac_board.sch, edge_connector.sch, interface.sch, out_chan.sch, power.sch, reference_buffer.sch]
2020-10-23 Everything seems ready to go for the DAC board. Made my BOM and checked it twice. Checked footprints of new components and fixed J5, R7-R10.
    [dac.sch, dac_board.kicad_pcb, dac_board.sch, edge_connector.sch, interface.sch, out_chan.sch, power.sch, reference_buffer.sch]
2020-10-23 Mainly BOM tweaks, working on setting up more systematic database of parts and BOMs in parts/
    [dac.sch, dac_board.kicad_pcb, dac_bom_digikey.csv, ilemt_parts.xlsx, input_bom_digikey.csv, main_bom_digikey.csv, out_chan.sch, power.sch]
2020-10-29 BOM change to dac/, start of board revision in input/adc.sch
    dac: changed 10 Ohm MPN on BOM
    input:
    Fixed SOIC-8 footprints
    Got rid of bootstrapping of the reference buffer. Now it runs from the 10 Ohm/330 uF filtered +8/-6.
    Changed power input beads from 22 Ohm to 180 Ohm.
    Added diode clamp between GND and Earth grounds.
    Changed reference buffer to dual opamp.
    [adc.sch, antialias_driver.sch, dac.sch, dac_bom_digikey.csv, ilemt_parts.xlsx, in_amp.sch, out_chan.sch, power.sch]
2020-11-20 Schematic revision for DAC board, compensation tweaks in lv_regs.
    Opamp +/- pins were swapped in reference_buffer.sch as side effect of the symbol change from using a dual opamp.
    lv_regs files. The compensation components were (CTUNE/RTUNE) were quite wrong, and everything oscillated like crazy. The positive regulators are fine with no compensation, and the negative regulator benefits from a bit.
    [dac.sch, lv_regs.sch, power.sch, reference_buffer.sch, reg_neg.sch, timeline.xlsx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]
2020-12-11 Fix to swapped opamp pins in reference_buffer.sch, assigned opamp type, annotated. Improved comments. Other changes are almost entirely kicad inflicted spurious modifications of multi-instance sub-sh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
    [antialias_driver.sch, in_amp.sch, in_filter.sch, input_channel.sch, power.sch, reference_buffer.sch]
2020-12-19 New files for output filter board.
    [filter_chan.sch, out_filter.kicad_pcb, out_filter.sch]
2021-01-01 Revision 0 of out_filter board. Tweaks to footprints, reducing pad size. General routing and pours.
    filter_chan.sch:
    deleted some testpoints, added input connector.
    out_filter.sch:
    Added output connector, changed ground testpoint footprint.
    [filter_chan.sch, out_filter.kicad_pcb, out_filter.sch]
2021-01-04 Added sma_breakout design, little board that connects the SMA jumper from the DAC card to the driver board.
    [sma_breakout.kicad_pcb, sma_breakout.sch]
2021-01-05 Had a 0.1" header rather than 0.2" on the SMA breakout, and also the gain trim rotation was the opposite of what I wanted. I changed the LPF filter values also, to 22 nF/360 Ohm.
    [sma_breakout.kicad_pcb, sma_breakout.sch]
2021-01-08 ~CARDSEL and config memory added to input board schematic, but not yet to the PCB. ~CARDSEL is now active low (before it was unimplemented).
    [adc.sch, antialias_driver.sch, board_connector.sch, input_board.kicad_pcb, reference_buffer.sch]
2021-01-14 Checkpoint before I start ripping the chassis ground components out of input_board.
    [filter_chan.sch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]
2021-01-15 Start of in_panel design, for input connectors on front panel, with RFI/ESD protection. These components moved from input_board.
    [adc.sch, antialias_driver.sch, board_connector.sch, in_filter.sch, in_panel.kicad_pcb, in_panel.sch, in_protect.sch, input_board.kicad_pcb]
2021-01-20 More work on in_panel. Also, shortened input_board by 10mm and tweaked the testpoints a bit, added another GND, and changed the supply TPs to be a hookable type.
    [in_panel.kicad_pcb, in_protect.sch, input_board.kicad_pcb, power.sch, probe_channel.sch, reference_buffer.sch, signal_in_connector.sch]
2021-01-27 in_panel is nearly complete, input/adc.sch: change testpoint style to loop. input/input_channel.sch: modification seems spurious
    [adc.sch, in_panel.kicad_pcb, in_panel.sch, in_protect.sch, input_board.kicad_pcb, input_channel.sch, probe_channel.sch, signal_in_connector.sch]
2021-01-28 Revision 0 of in_panel, off to fab
    [in_panel.kicad_pcb, in_panel.sch, in_protect.sch, probe_channel.sch, signal_in_connector.sch]
2021-02-08 Input board revisions, mostly related to reference buffer.
    power.sch: changed +3.3V to use the NCP1117 adjustable regulator, the MCP1577 was so noisy it was injecting noise into the ground plane, disturbing the VREF distribution. Fixed fuse footprint, was too small.
    reference_buffer.sch: added series resistor R40 on VREF buffer feedback cap C2, this adds damping to the response, avoiding noise peaking and overshoot. Changed VREF bias R5/R14 to be taken from V+, rather than FILT_+10V. V+ is a much lower noise regulated output, but this does reintroduce a bootstrapping issue between VREF and V+. We don't get any startup problems here, though, because U3B can source current into VREF (from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
    [adc.sch, ilemt_parts.xlsx, input_board.kicad_pcb, input_channel.sch, power.sch, reference_buffer.sch]
2021-02-08 Added thermal copper pours on regulator power devices.
    [input_board.kicad_pcb]
2021-02-16 Mainly BOM changes to input board.
    Changed "DK line" attribute from plain "3" ti "I.3", reflecting the evolving interpretation of this as a part code. This
    causes all the input schematics to be modified. Filled out some attributes
    sma_breakout.sch: updated notes
    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
    [adc.sch, antialias_driver.sch, bist_buffer.sch, board_connector.sch, in_amp.sch, in_filter.sch, in_panel.kicad_pcb, input_board.sch]
2021-02-17 Input board R1 being sent to fab. Changes related to BOM reconciliation with the Digikey BOM. This includes a couple of fixes to the footprint which affected the layout, as well as a couple changes t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
    [adc.sch, antialias_driver.sch, bist_buffer.sch, bom_compare.xlsx, in_amp.sch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]
2021-03-04 Notes, update bom_compare.xlsx for input board build.
    [bom_compare.xlsx]
2021-03-15 No real hardware changes, but updates to documentation, notes, drawings in_panel.kicad_pcb: added drawings dimensioning front panel features
    [in_panel.kicad_pcb, signal_in_connector.sch]
2022-04-20 Mainly much more detailed documentation of the sensor pinout wrt the RJ45 standards, see docs/Rj45_probe_pinout.xlsx
    [Rj45_probe_pinout.xlsx, input_channel.sch, probe_channel.sch, probe_connector.sch, signal_in_connector.sch]
2022-08-03 Notes on hotplate soldering, 3D_guidance_sensor_clamp.SLDPRT
    [3D_guidance_sensor_clamp.SLDPRT]
2022-08-26 Update to soldering notes
2022-10-27 Cap for premo coil, updated docs.txt for soldering tips. Newer version kicad project files.
    [cap.SLDPRT]
2023-03-03 Tweak soldering notes
2026-09-15 CAD files for EMOTO test holders, doc tweaks.
    [1dof_cal_base.SLDPRT, 3DC09LP.SLDPRT, 3DC09LP.step, 3DCC08.step, 3DCC08_source_holder.SLDPRT, 3DV09_sensor_assy.SLDASM, 3DV09_sensor_holder.SLDPRT]
2026-09-17 Added driver/low_power/
    [filter_chan.kicad_sch, low_power.kicad_pcb, low_power.kicad_sch]
